yfnuaa/stm8_train_air/work_list.txt

1, test timer1 acuracy, use shiboqi
2, teset timer4 acuracy, use shiboqi
3, ??ADC???
4, ?? SHARP??
5, ?? CO2?????
