yfnuaa/stm8_train_air/Sensor_power_pwm_stuf/Power/NCP1034_EVB_SCHEMATIC.PDF

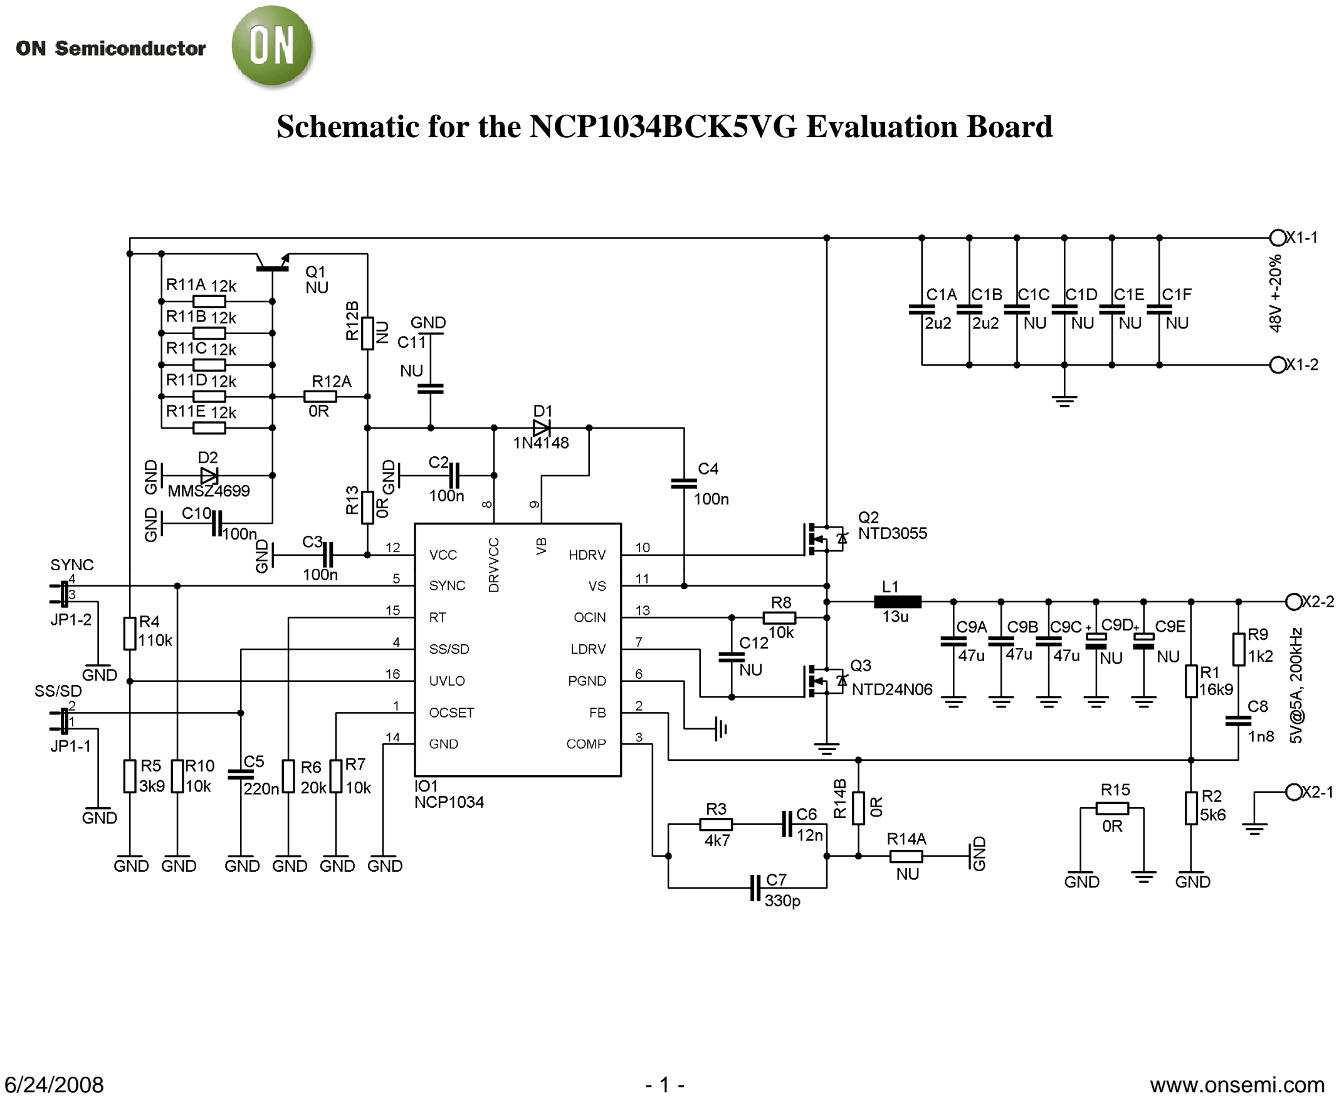
[picture p1: page 1]

6/24/2008 | - 1 - | www.onsemi.com

Schematic for the NCP1034BCK5VG Evaluation Board
