yfnuaa/stm8_train_air/MG812_ADC_ref.png

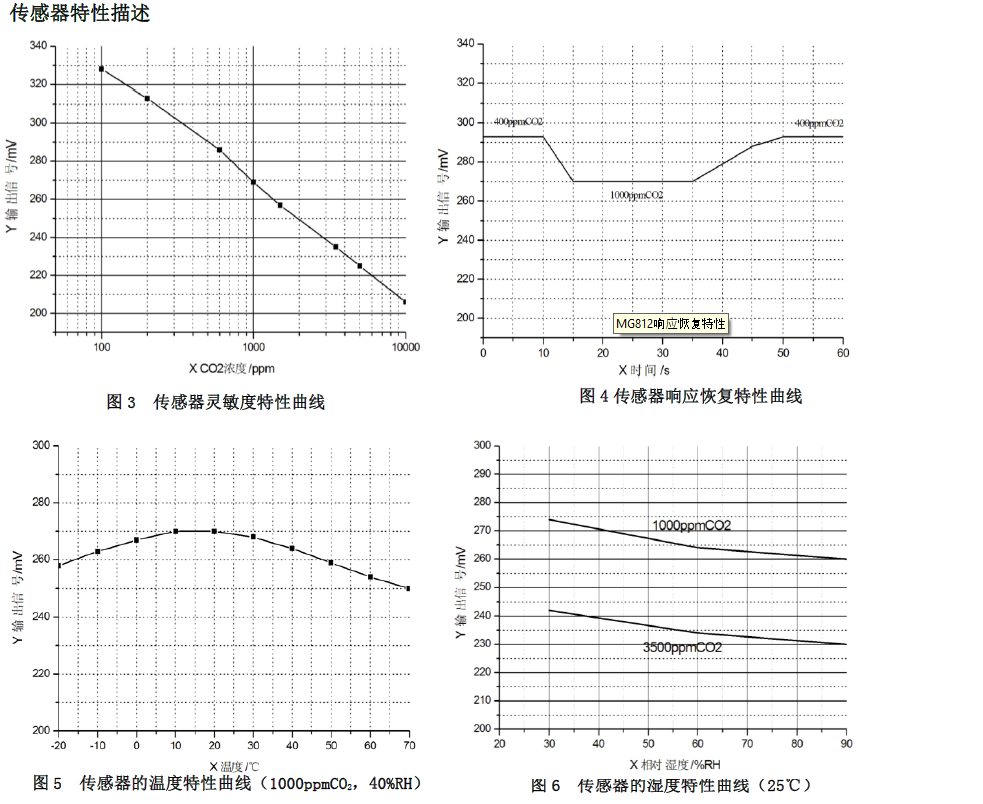
MG812_ADC_ref.png
