yfnuaa/stm8_train_air/sharp_ADC_ref.png

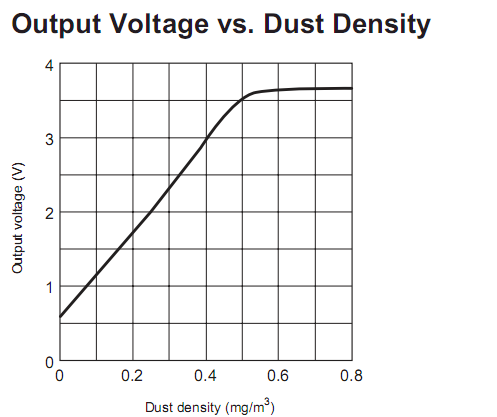
sharp_ADC_ref.png
