yfnuaa/stm8_train_air/trainAir-spec&cost.xlsx

Sheet: cost
MainBoard |  |  |  |  |  | Power Board
fixed | TFT | 17 |  |  |  | fixed |  | H6201 | SL3038
 | PCB | 2.7 |  |  |  |  | PCB | 2.7 | 2.7
 | smt | 5 |  |  |  |  | smt | 5 | 5
 | power | 16.8 |  |  |  |  | 芯片 | 1.5 | 1.5
 | CO2 | 40 |  |  |  |  | 双二极管 | 0.5 | 0.5
 | PM2.5 | 18 |  |  |  |  | MOS | 1.5 | 1.5
 | 插针+座 | 0.8 | 4*0.2 |  |  |  | 电感 | 0.6 | 0.6
 | MCU | 1
 | touch芯片 | 0.9 |  |  |  | variable | 电容+电阻 | 5 | 5
 | OP | 1.3
 | 线束 | 1.6 | 0.8*2
 | 散热器 | 1.2
variable | 电容+电阻 | 5
TOTAL |  | 111.3
 |  |  |  |  |  | TOTAL |  | 16.8 | 16.8
SMT fee
 | main pcb |  |  |  |  |  | power pcb
 |  |  | price | count |  |  |  |  | price | count
 | point | 46 | 0.015 | 1000 | 690 |  | point | 46 | 0.015 | 1000 | 690
 | insert point | 74 | 0.04 | 1000 | 2960 |  | insert point | 74 | 0.04 | 1000 | 2960
 | meta types | 22 | 10 | 1 | 220 |  | meta types | 22 | 10 | 1 | 220
 | engine fee | 0 | 100 | 1 | 100 |  | engine fee |  | 100 | 1 | 100
 | metal net | 0 | 80 | 1 | 80 |  | metal net |  | 80 | 1 | 80
 | total fee |  |  |  | 4050 |  | total fee |  |  |  | 4050
 |  |  |  |  |  | 工程费100元，物料费用是220元，贴片是345元（现在是0.015一个点），插件1480元（0.04一个点），钢网是80元
嘉立创的价格 嘉立创不提供自带料
举例：有5片板子需要SMT贴片，每片板子上200个焊点。那么，5片 x 200个焊点 = 总共1000个焊点，则焊点费：1000 x 0.01 = 10元
SMT总计：10焊点费 + 50工程费 + 0激光钢网 = ￥ 60元
 | power pcb
 |  |  | price | count
 | point | 92 | 0.01 | 1000 | 920
 | insert point | 74 | 0.04 | 1000 | 2960
 | meta types | 0 | 0 | 1 | 0
 | engine fee | 0 | 50 | 1 | 0
 | metal net | 0 | 1 | 1 | 0
 | total fee |  |  |  | 3880

Sheet: spec
需求： | BOM
1 | STM8s003
2 | SHARP + 运放 | PM2.5传感器+GP2Y1014AU粉尘传感器
3 | MG812 + 运放 | 炜盛CO2
4 | TFT液晶/HT621B | 4com 14 seg
5 | touch | 4 key touch
6 | DC-DC | 24V->5V
7 | DC-DC | 96V->24V
8 | MOTO | 24V moto 24vpower on all the time?
9 | PWM | 24V moto 0-5v pwm
10

Sheet: Sheet1
 | power | main board | CO2小板 | MG812 | sharp | Toatal
V1 PCB | 15 | 15
V1 SMT | 0 | 0
V2 PCB | 15 | 40
V2 SMT | 0 | 80
V3 PCB | 30 | 30 | 45
V3 SMT | 146 | 114
 |  |  |  | 40*8 | 100
 | 206 | 279 | 45 | 320 | 100 | 950
