yfnuaa/stm8_train_air/pcb_stuff/v3.0/bom_fan-checked.xlsx

客户BOM清单 |  |  |  |  |  |  |  |  |  | 嘉立创元件库
序号 | Comment | Description | Designator | Footprint | LibRef | Pins | Quantity | 元件名称 | 封装规格 | 元件总数量 | 元件编号 | T层位号 | 元件单价 | 小计 | 收费原因
1 | 2.2uF |  | C4,C2, | 1206+ | C+ | 2 | 2 | 2.2uF (225) ±10% 50V | 1206 | 10 | C12656 | C4, C2 | 0.6918 | 8.3016
2 | 104 | 805 | C23,C20,C19, | 603 | C' | 2 | 3 | 100nF (104) ±10% 50V | 603 | 15 | C14663 | C23, C20, C19 | 0.2799 | 4.1985
3 | 0K | 603 | R25,R15, | 603 | R' | 2 | 1 | 0Ω (0R0) ±1% | 603 | 5 | C21189 | R25 | 0.0195 | 0.0975
4 | 100R | 805 | R11,~~R12~~, | 603 | R' | 2 | 2 | 100Ω (1000) ±1% | 603 | 10 | C22775 | R11, R12 | 0.0195 | 0.195
5 | 100R | 603 | R26, | 603 | R' | 2 | 1 | 100Ω (1000) ±1% | 603 | 5 | C22775 | R26 | 0.0195 | 0.0975
6 | 100 | 805 | R13, | 603 | R' | 2 | 1 | 100Ω (1000) ±1% | 603 | 5 | C22775 | R13 | 0.0195 | 0.0975
7 | 150K | 603 | R30, | 603 | R' | 2 | 1 | 150KΩ (1503) ±1% | 603 | 5 | C22807 | R30 | 0.012 | 0.06
8 | 30K | 603 | R32, | 603 | R' | 2 | 1 | 30KΩ (3002) ±1% | 603 | 5 | C22984 | R32 | 0.018 | 0.09
9 | 4.7K | 805 | R29,R19, | 603 | R' | 2 | 2 | 4.7KΩ (4701) ±1% | 603 | 10 | C23162 | R29, R19 | 0.0193 | 0.193
10 | 4.7K | 603 | R28,R6, | 603 | R' | 2 | 2 | 4.7KΩ (4701) ±1% | 603 | 10 | C23162 | R28, R6 | 0.0193 | 0.193
11 | 100K | 805 | R16, | 603 | R' | 2 | 2 | 100KΩ (1003) ±1% | 603 | 10 | C25803 | R16, R15 | 0.0215 | 0.215
12 | 10K | 805 | R33,R27,R24,R18,R41, | 603 | R' | 2 | 5 | 10KΩ (1002) ±1% | 603 | 25 | C25804 | R33, R27, R24, R18, R41 | 0.0178 | 0.445
13 | 10k | 603 | R54,R52,R51,R1,R53, | 603 | R | 2 | 5 | 10KΩ (1002) ±1% | 603 | 25 | C25804 | R54, R52, R51, R1, R53 | 0.0178 | 0.445
14 | 10K | 603 | R8,R7,R2, | 603 | R | 2 | 3 | 10KΩ (1002) ±1% | 603 | 15 | C25804 | R8, R7, R2 | 0.0178 | 0.267
15 | 10K | 603 | R31, | 603 | R' | 2 | 1 | 10KΩ (1002) ±1% | 603 | 5 | C25804 | R31 | 0.0178 | 0.089
16 | 150 | 805 | R10, | 603 | R' | 2 | 1 | 150Ω ±1% 50ppm [SMT4期 1020] | 805 | 5 | C57863 | R10 | 0.0614 | 1.228
17 | 9013 |  | T9,T8,T5,T1, | 9013 | 9013 | 3 | 4 | S9013 J3 | SOT-23 | 20 | C6749 | T9, T8, T5, T1 | 0.136 | 2.72
18 | 200 | 603 | R5,R40, | 603 | R | 2 | 2 | 200Ω (2000) ±1% | 603 | 10 | C8218 | R5, R40 | 0.0198 | 0.198
19 | D |  | D5, | D0805 | D | 2 | 1 | 1N4148WS | SMA,DO-214AC | 5 | C95872 | D5 | 0.0811 | 0.4055
20 | <-以下为不贴装的元件->
21 | STM8S003F3 |  | U2 | STM8S003F3 | STM8S003F3 | 20 | 1
22 | 220uF |  | ~~C8~~ | C+_6.3-7 | C+ | 2 | 1
23 | BEEPER |  | J6 | BEEP-D12 | BEEPER | 4 | 1
24 | CON3*2 |  | J8,J9,J11,J10 | CON3*2 | CON3*2 | 6 | 4
25 | CON4 |  | J1 | CON4_L | CON4 | 4 | 1
26 | CA3140 |  | U7 | LF353 | CA3140 | 8 | 1
27 | LCD |  | U1 | LCD-DIP-26 | LCD-3 | 26 | 1
28 | AO3401 |  | T7,T4,T10 | AO3401 | AO3401 | 3 | 3
29 | 32.728 |  | X1 | XTAL-32768 | XTAL | 3 | 1
30 | 4.7K | 603 | R | 603 | S | 2 | 1
31 | C+ |  | C24 | C+ | C+ | 2 | 1
32 | 10UF |  | C12 | C+_6.3-5.5 | C+ | 2 | 1
33 | TTP224 |  | U5 | TTP224 | TTP224 | 16 | 1
34 | LM358 | Amps | U4 | LM358 | LM358 | 8 | 1
~~35~~ | ~~5pF~~ | ~~603~~ | ~~C6,C5~~ | ~~603~~ | ~~C~~ | ~~2~~ | ~~2~~
36 | 1uF | 603 | C22,C13,C25 | 603 | C | 2 | 3
37 | 0.1uF | 603 | C7,C3 | 603 | C | 2 | 2
38 | 30pF | 603 | C17,C16,C15,C14 | 603 | C | 2 | 4
39 | 1uF | 805 | C11,C9~~,C10~~ | 603 | C' | 2 | 3
40 | 104 | 603 | C21 | 603 | C' | 2 | 1
41 | HT1621B |  | U3 | HT1621B | HT1621B | 48 | 1
42 | 104 | 603 | C18 | 603 | C | 2 | 1
43 | 10nF | 603 | C1 | 603 | C | 2 | 1
220uf |  | 电解电容 |  | power board | 4.7uF/0805 | 50v
10UF |  | 电解电容 |  |  | 10uF/35V/1206
2.2uf |  | ·0603 |  |  | 10uF/160V/1206
1uf | 105 | ·0603 |  |  | 10uF/50V/1206
0.1uf | 104 | ·0603 |  |  | 1uf 105/1210 | 50v
10nf | 103 | ·0603 |  |  | 330uF/250V | 电解电容
 |  |  |  |  | 470uF/63V | 电解电容
 |  |  |  |  | 100uF/16V | 电解电容
