yfnuaa/stm8_train_air/pcb_stuff/v3.0/bom_pow-checked.xlsx

客户BOM清单
序号 | Comment | Description | Designator | Footprint | LibRef | Pins | Quantity | 元件名称 | 封装规格 | 元件编号 | 元件单价 | 小计 | 收费原因
1 | 12K/0805 | 603 | R4, | 805 | R | 2 | 1 | 12KΩ (1202) ±1% | 805 | C17444 | 0.0339 | 0.1695
2 | 3.9K/1%/0805 | 603 | R8,R5, | 805 | R | 2 | 2 | 3.9KΩ (3901) ±1% | 805 | C17614 | 0.0273 | 0.273
3 | 51K/1206 | 603 | R1, | 1206 | R | 2 | 1 | 51KΩ (5102) ±1% | 805 | C17737 | 0.0336 | 0.168
4 | 240K/1%/0805 | 603 | R7,R6, | 805 | R | 2 | 2 | 240KΩ (2403) ±1% | 805 | C25824 | 0.0222 | 0.222
5 | S3M |  | D3, | S3M | D | 2 | 1 | S3M [SMT4期 ] | SMB,DO-214AA | C47524 | 0.2808 | 2.808 | 10个以内不管购买几个都收费2.8080元 | peak1000v
6 | 0R13/1%/1206 | 603 | R9,R3,R2, | 1206 | R | 2 | 3 | 0.13Ω(R130) ±1% [SMT4期 821] | 1206 | C61472 | 0.0741 | 1.2597
7 | SS3200 |  | D4, | S3M | D | 2 | 1 | SS3200 [SMT4期 ] | SMA,DO-214AC | C65001 | 0.3276 | 3.276 | 10个以内不管购买几个都收费3.2760元 | 200V
9 | 200R/1206 | 603 | R10, | 1206 | R | 2 | 1 | 200Ω (2000) ±1% | 603 | C8218 | 0.0198 | 0.099
10 | SS34 |  | D6, | SS34 | DI | 2 | 1 | SS34 | SMA,DO-214AC | C84635 | 0.2406 | 1.203 |  | SS34为贴片肖特基二极管，常用在小电流的（模型）电调上用，用于电路瞬间整流。其中白色段为负极
11 | <-以下为不贴装的元件->
12 | 4.7uF/0805 | 603 | C6 | 805 | C | 2 | 1 | 50V
13 | 10uF/35V/1206 | 603 | C7 | 1206 | C | 2 | 1
14 | 27V/0.5W |  | Z1 | SOD123 | DI | 2 | 1 | BZT52C18
15 | 10uF/160V/1206 | 603 | C4 | 1206 | C | 2 | 1
16 | XL1509-5.0E1 |  | U1 | XL1509 | XL1509-5.0E1 | 8 | 1
17 | 10uF/50V/1206 | 603 | C5 | 1206 | C | 2 | 1
18 | 100uF/16V |  | C1 | C+_6.3-7 | C+ | 2 | 1
19 | SS110 |  | D7 | S3M | D | 2 | 1 |  |  |  |  |  |  | 100V 1A
20 | 105/1210 | 603 | C9,C2 | 1210 | C | 2 | 2
21 | FUSE |  | F1 | PPTC-10MM | FUSE | 2 | 1
22 | SL18N20 | MOS-N | Q1 | IRFR220N | MOS-N | 3 | 1
23 | FAN |  | U4 | FAN-26*26MM | FAN | 2 | 1
24 | 330uF/250V |  | C3 | C-18-8 | C+ | 2 | 1
25 | CON6 |  | J15 | CON6-1.5mm | CON6 | 8 | 1
26 | 68uH/1mm |  | L2 | L-6MM | L | 2 | 1
27 | CON3 |  | J18,J17,J16 | CON3 | CON3 | 3 | 3
28 | CON3*2 |  | J11,J10,J9,J8 | CON3*2 | CON3*2 | 6 | 4
29 | BZ1303A |  | U*1 | BZ1303A | BZ1303A | 8 | 1
30 | 470uF/63V |  | C8 | C-12-5 | C+ | 2 | 1
31 | 47uH/2A |  | L1 | L-CD75 | L | 2 | 1
32 | CON2 |  | J1 | CON2-5.08 | CON2 | 2 | 1
S3M
SS3200
SS34
BZT52C18 | 27V/0.5W
SS110
4.7uF/0805 | 50V
10uF/35V/1206
10uF/160V/1206
10uF/50V/1206
105/1210 | 50v
330uF/250V | 电解电容
470uF/63V | 电解电容
100uF/16V | 电解电容
