yfnuaa/stm8_train_air/pcb_stuff/v3.0/PowerSystem_bom.xls

Comment | Description | Designator | Footprint | LibRef | Quantity
100uF/16V |  | C1 | C+_6.3-7 | C + | 1.0
105/1210 | 0603 | C2, C9 | 1210 | C | 2.0
330uF/250V |  | C3 | C-18-8 | C + | 1.0
10uF/160V/1206 | 0603 | C4 | 1206 | C | 1.0
10uF/50V/1206 | 0603 | C5 | 1206 | C | 1.0
4.7uF/0805 | 0603 | C6 | 0805 | C | 1.0
10uF/35V/1206 | 0603 | C7 | 1206 | C | 1.0
470uF/63V |  | C8 | C-12-5 | C + | 1.0
SS520 |  | D1, D2 | DO-214AA | D | 2.0
S3M |  | D3 | S3M | D | 1.0
SS3200 |  | D4 | S3M | D | 1.0
SS34 |  | D6 | SS34 | DI | 1.0
SS110 |  | D7 | S3M | D | 1.0
FUSE |  | F1 | PPTC-10MM | FUSE | 1.0
CON2 |  | J1 | CON2-5.08 | CON2 | 1.0
CON3*2 |  | J8, J9, J10, J11 | CON3*2 | CON3*2 | 4.0
CON6 |  | J15 | CON6-1.5mm | CON6 | 1.0
CON3 |  | J16, J17, J18 | CON3 | CON3 | 3.0
68uH/2A |  | L1 | L-CD75 | L | 1.0
100uH/1mm |  | L2 | L-6MM | L | 1.0
SL18N20 | MOS-N | Q1 | IRFR220N | MOS-N | 1.0
51K/1206 | 0603 | R1 | 1206 | R | 1.0
0R13/1%/1206 | 0603 | R2, R3, R9 | 1206 | R | 3.0
12K/0805 | 0603 | R4 | 0805 | R | 1.0
3.9K/1%/0805 | 0603 | R5, R8 | 0805 | R | 2.0
240K/1%/0805 | 0603 | R6, R7 | 0805 | R | 2.0
200R/1206 | 0603 | R10 | 1206 | R | 1.0
TP |  | TP7, TP8, TP9 | CON1 | TP | 3.0
XL1509-5.0E1 |  | U1 | XL1509 | XL1509-5.0E1 | 1.0
FAN |  | U4 | FAN-26*26MM | FAN | 1.0
BZ1303A |  | U*1 | BZ1303A | BZ1303A | 1.0
27V/0.5W |  | Z1 | SOD123 | DI | 1.0
