yfnuaa/stm8_train_air/Sensor_power_pwm_stuf/Power/SL3038/SL3038【Bom清单V1.0】30-100V+Vo=24V_3.0A.xls

深圳市森利威尔电子有限公司
SL3038降压恒压24V/3.0A-BOM
型号:SL3038 |  |  | 规格: Vin=DC(30-100)V;Vo=24V;Io=3.0A | 设计: |  |  | 日期: 2017/01/01
NO. | Part Types | Symbol |  | Qty. | Unit | Vendor | Remarks
1 | 贴片电阻 | R1 R2 R3 |  | 3 | Pcs
2 |  | R4 |  | 1 | Pcs
3 |  | R5 |  | 1 | Pcs
4 |  | R7 R8 |  | 1 | Pcs |  | 输出电压设定分压电阻
5 |  | R7A R8A |  | 1 | Pcs
6 |  | R9 |  | 1 | Pcs |  | 假负载电阻
7 | 贴片电容 | C1 |  | 1 | Pcs
8 |  | C2 |  | 1 | Pcs
9 |  | C3 |  | 1 | Pcs
10 | 电解电容 | EC1 |  | 1 | Pcs
11 |  | EC2 |  | 1 | Pcs
12 | 贴片二极管 | D1 D2 |  | 0 | Pcs |  | 输入防反接二极管
13 |  | D3 D4 |  | 2 | Pcs
14 |  | D5 | 1N4148/100V/0.15A/LL34 | 1 | Pcs
16 | MOS管 | Q1 |  | 1 | Pcs
17 | 电感 | L1 |  | 1 | Pcs
18 | 稳压管 | Z1 | 18V/SOD123/0.25W | 1 | Pcs
19 | IC | U1 |  | 1 | Pcs
20 | PCB板 |  |  | 1 | Pcs | SL3038
备注：
