yfnuaa/stm8_train_air/pcb_stuff/v3.0/FanSystem_bom.xls

Comment | Description | Designator | Footprint | LibRef | Quantity
TP |  | 5V, G1, G2, G3 | CON1 | TP | 4.0
10nF | 0603 | C1 | 0603 | C | 1.0
2.2uF |  | C2, C4 | 1206+ | C + | 2.0
0.1uF | 0603 | C3, C7 | 0603 | C | 2.0
5pF | 0603 | C5, C6 | 0603 | C | 2.0
220uF |  | C8 | C+_6.3-7 | C + | 1.0
1uF | 0805, 0805, 0805, 0603, 0603, 0603 | C9, C10, C11, C13, C22, C25 | 0603 | C', C', C', C, C, C | 6.0
10UF |  | C12 | C+_6.3-5.5 | C + | 1.0
30pF | 0603 | C14, C15, C16, C17 | 0603 | C | 4.0
104 | 0603, 0805, 0805, 0603, 0805 | C18, C19, C20, C21, C23 | 0603 | C, C', C', C', C' | 5.0
C + |  | C24 | C+ | C + | 1.0
D |  | D5 | D0805 | D | 1.0
CON4 |  | J1 | CON4_L | CON4 | 1.0
BEEPER |  | J6 | BEEP-D12 | BEEPER | 1.0
CON3*2 |  | J8, J9, J10, J11 | CON3*2 | CON3*2 | 4.0
10k | 0603, 0603, 0603, 0603, 0805, 0805, 0805, 0603, 0805, 0805, 0603, 0603, 0603, 0603 | R1, R2, R7, R8, R18, R24, R27, R31, R33, R41, R51, R52, R53, R54 | 0603 | R, R, R, R, R', R', R', R', R', R', R, R, R, R | 14.0
200 | 0603 | R5, R40 | 0603 | R | 2.0
4.7K | 0603, 0805, 0603, 0805 | R6, R19, R28, R29 | 0603 | R' | 4.0
150 | 0805 | R10 | 0603 | R' | 1.0
100R | 0805, 0805, 0603 | R11, R12, R26 | 0603 | R' | 3.0
100 | 0805 | R13 | 0603 | R' | 1.0
100K | 0805 | R15, R16 | 0603 | R' | 2.0
0K | 0603 | R25 | 0603 | R' | 1.0
150K | 0603 | R30 | 0603 | R' | 1.0
30K | 0603 | R32 | 0603 | R' | 1.0
S |  | S5 | 0603 | S | 1.0
9013 |  | T1, T5, T8, T9 | 9013 | 9013 | 4.0
AO3401 |  | T4, T7, T10 | AO3401 | AO3401 | 3.0
TP |  | TP7, TP9, TP11, TP20, TP21, TP22, TP23, TP24, TP25, TP26, TP27, TP28 | tp | TP | 12.0
LCD |  | U1 | LCD-DIP-26 | LCD-3 | 1.0
STM8S003F3 |  | U2 | STM8S003F3 | STM8S003F3 | 1.0
HT1621B |  | U3 | HT1621B | HT1621B | 1.0
LM358 | Amps | U4 |  | LM358 | 1.0
TTP224 |  | U5 | TTP224 | TTP224 | 1.0
CA3140 |  | U7 | LF353 | CA3140 | 1.0
32.728 |  | X1 | XTAL-32768 | XTAL | 1.0
