yfnuaa/stm8_train_air/(list of files, cad)

Other CAD files:
stvp_proj/stm8sdownload.stp
train_air_proj.stp
stvp_proj/dowmload.stp
