yfnuaa/stm8_train_air/pcb_stuff/v3.0/PowerSystem-V3.0.pdf

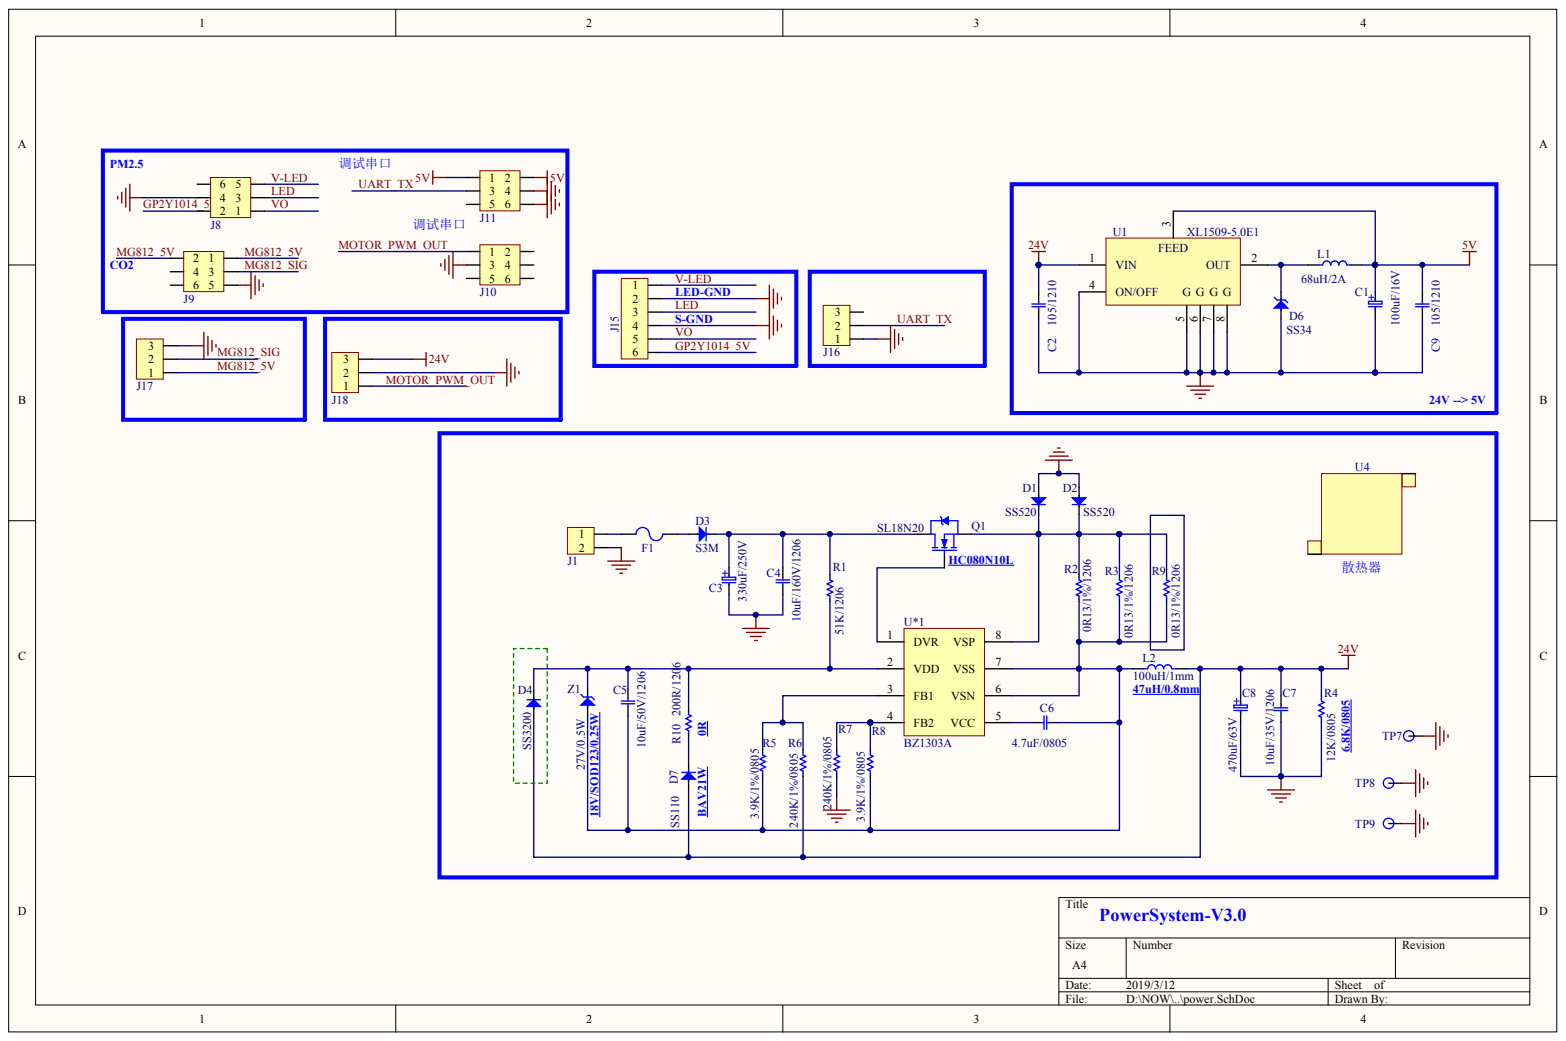
[picture p4: page 1]

FEED

ON/OFF 4 G G | 24V --> 5V

DVR 1 | VSS

VDD 2 | 7

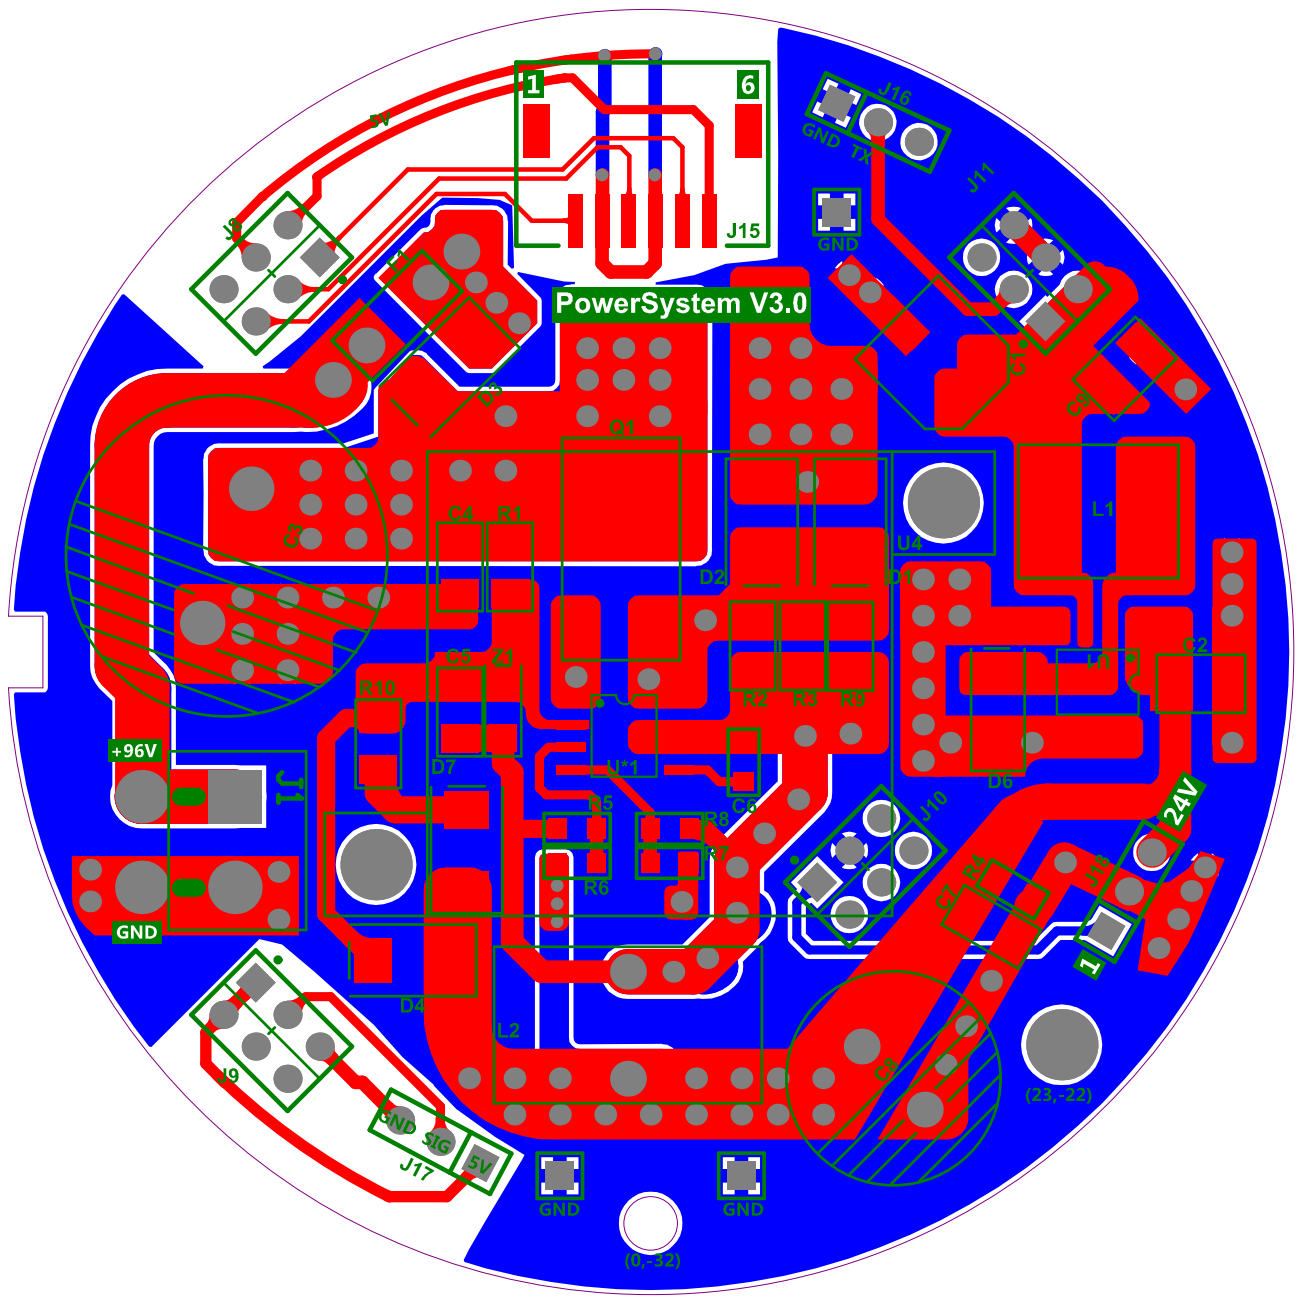
[picture p5: page 2]
