yfnuaa/stm8_train_air/pcb_stuff/v3.0/FanSystem-V3.0.pdf

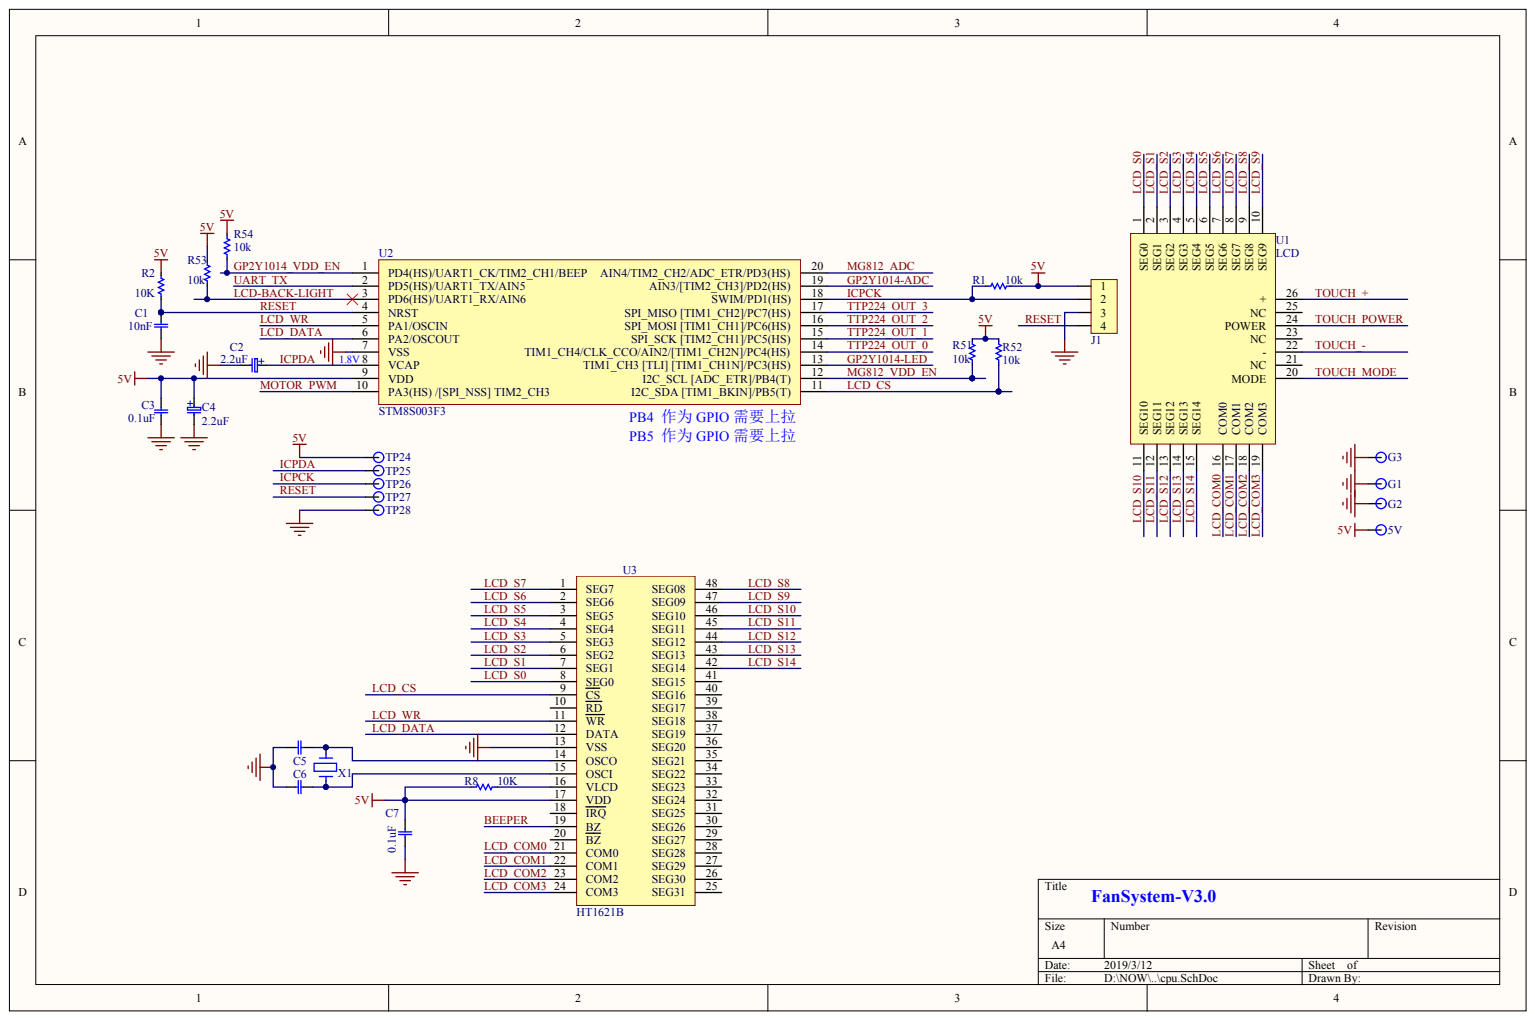
[picture p6: page 1]

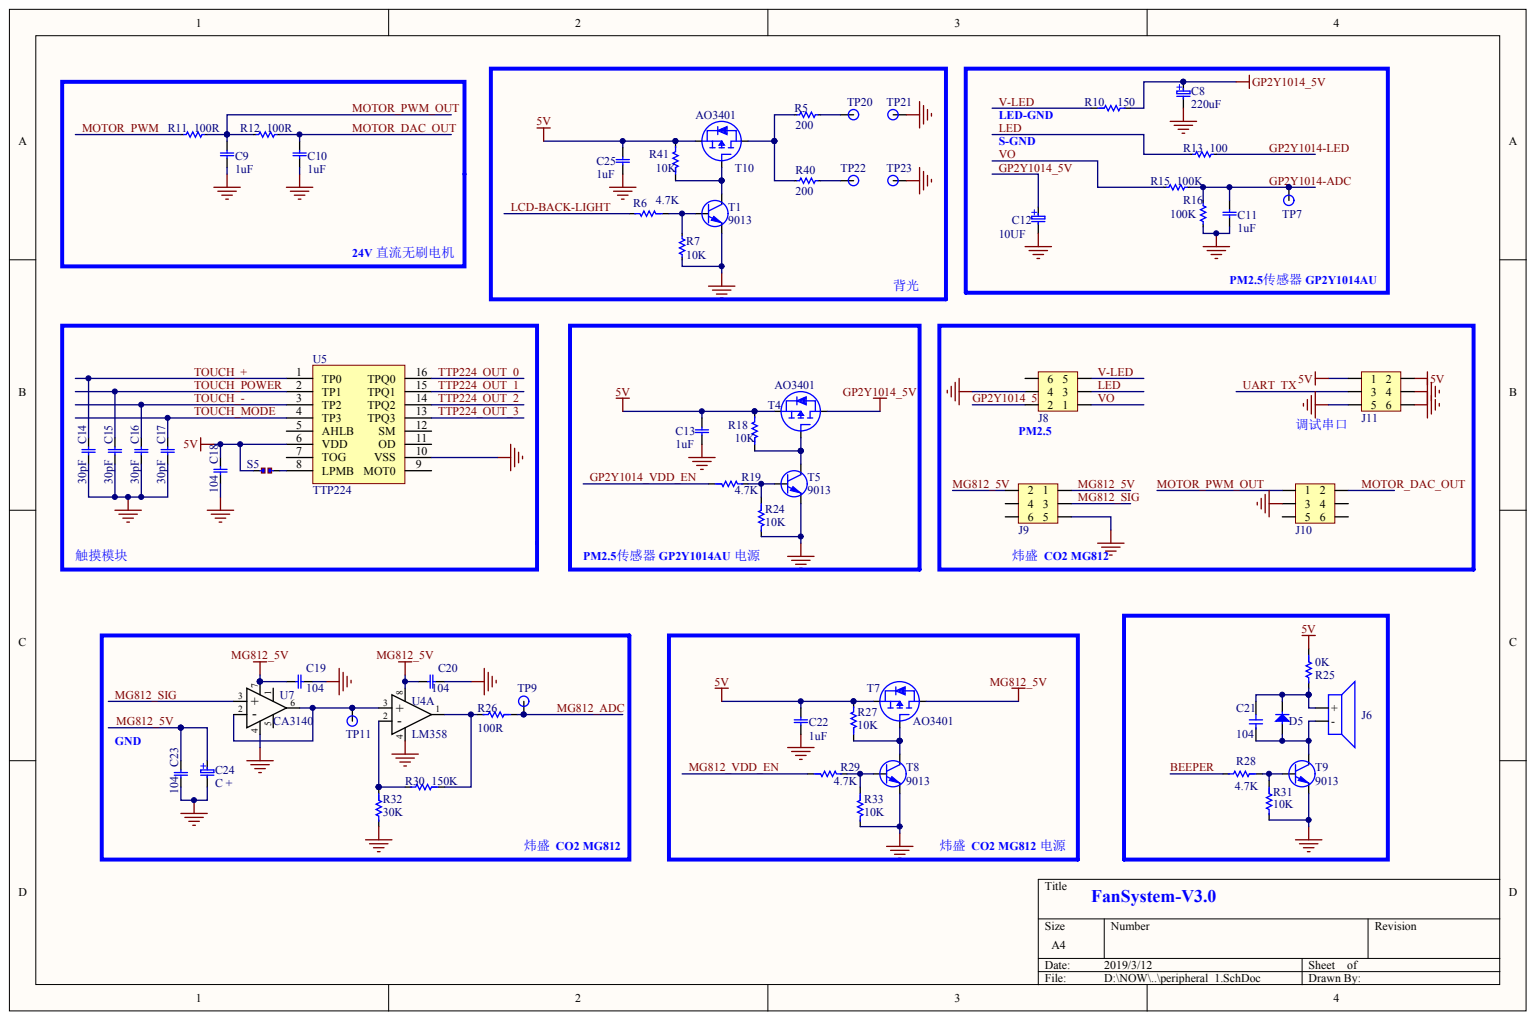
[picture p7: page 2]

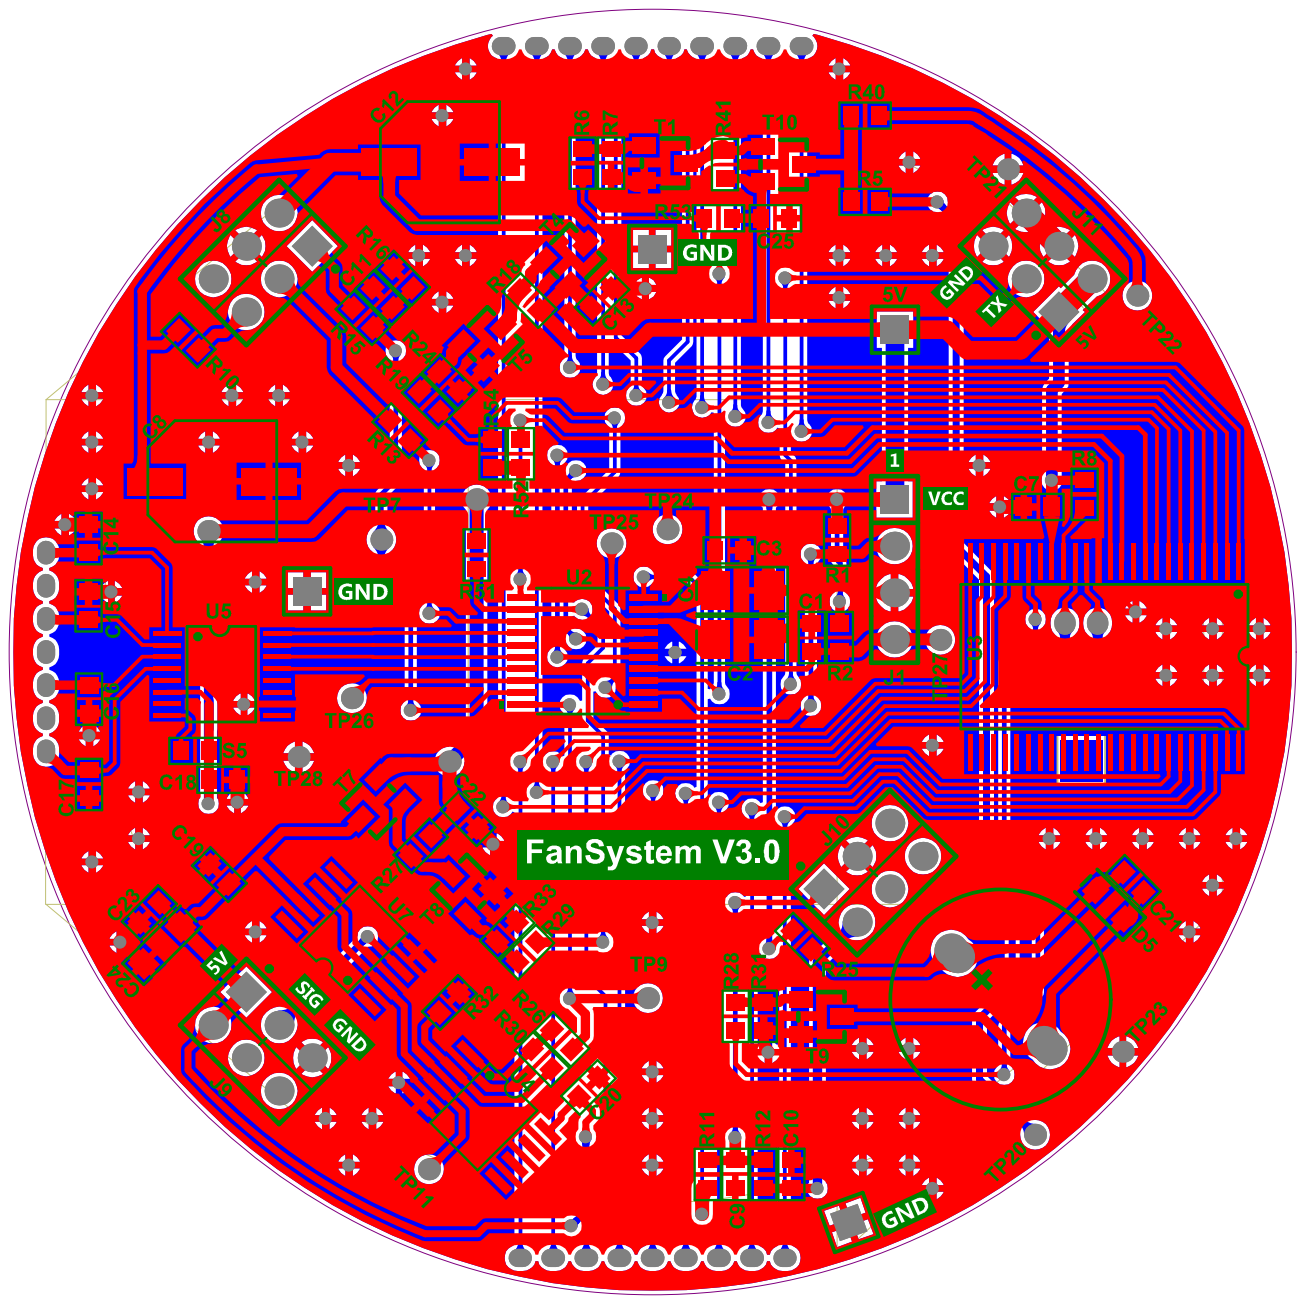
[picture p8: page 3]
