yfnuaa/stm8_train_air/Sensor_power_pwm_stuf/Power/H6201【原理图】VB27+28-85V+TO+24V+2A.pdf

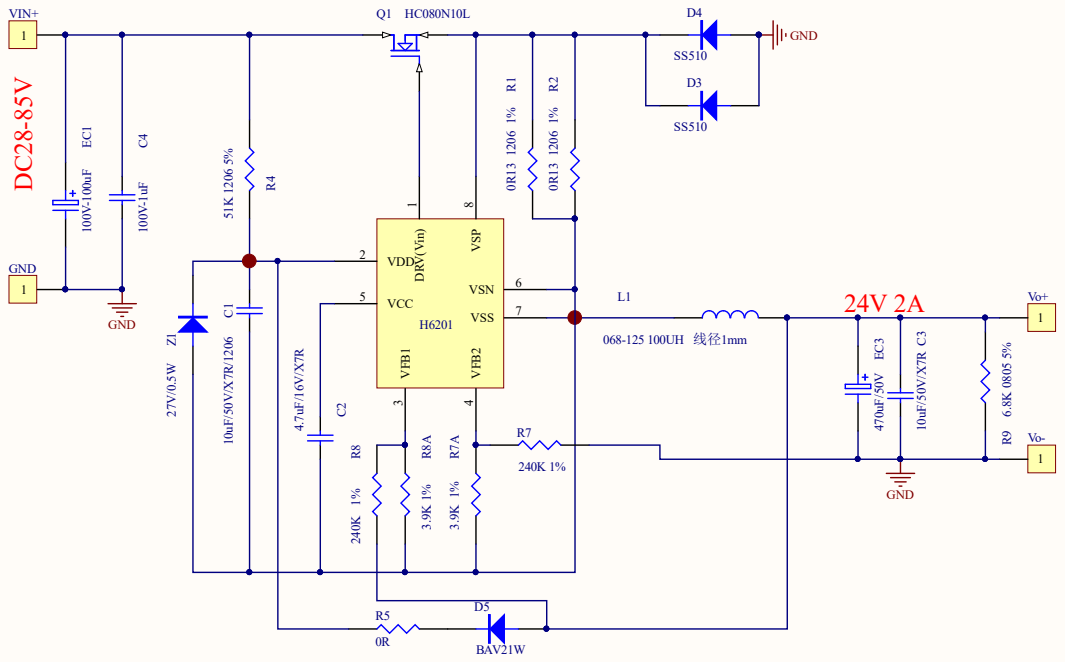
[picture p9: page 1]
