yfnuaa/stm8_train_air/pcb_stuff/v1.0/PowerSystem-V1.0.pdf

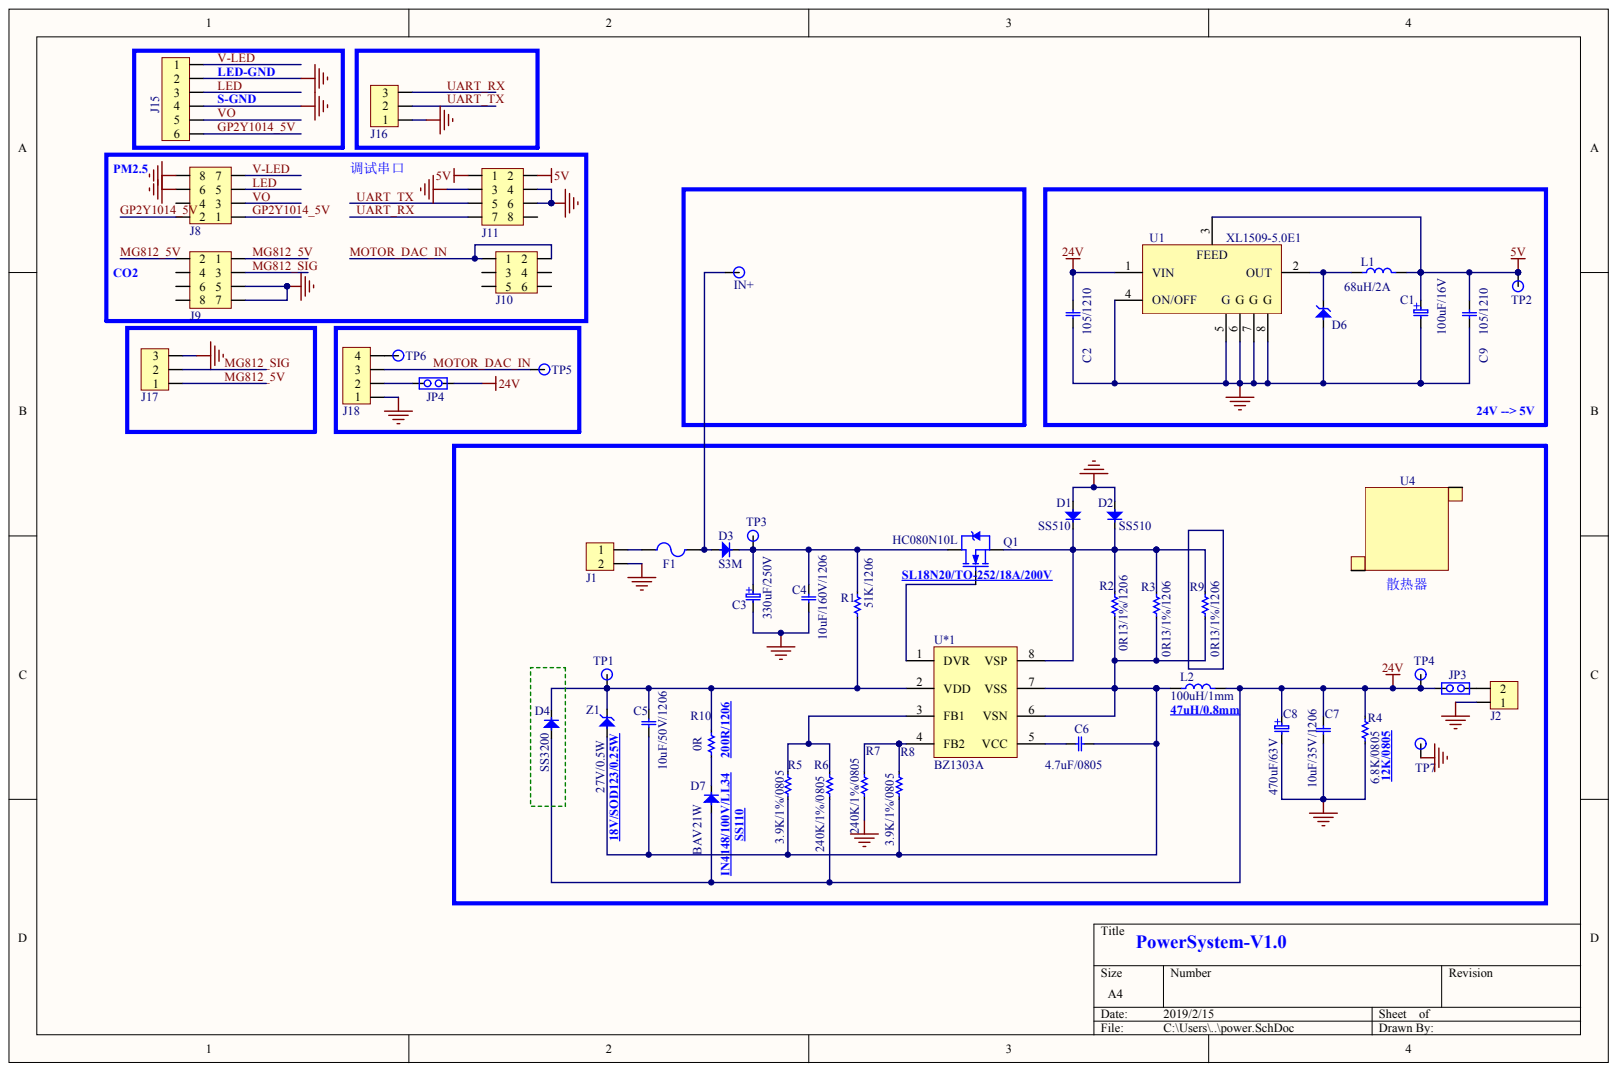
[picture p10: page 1]

FEED

ON/OFF 4 G G | 24V --> 5V

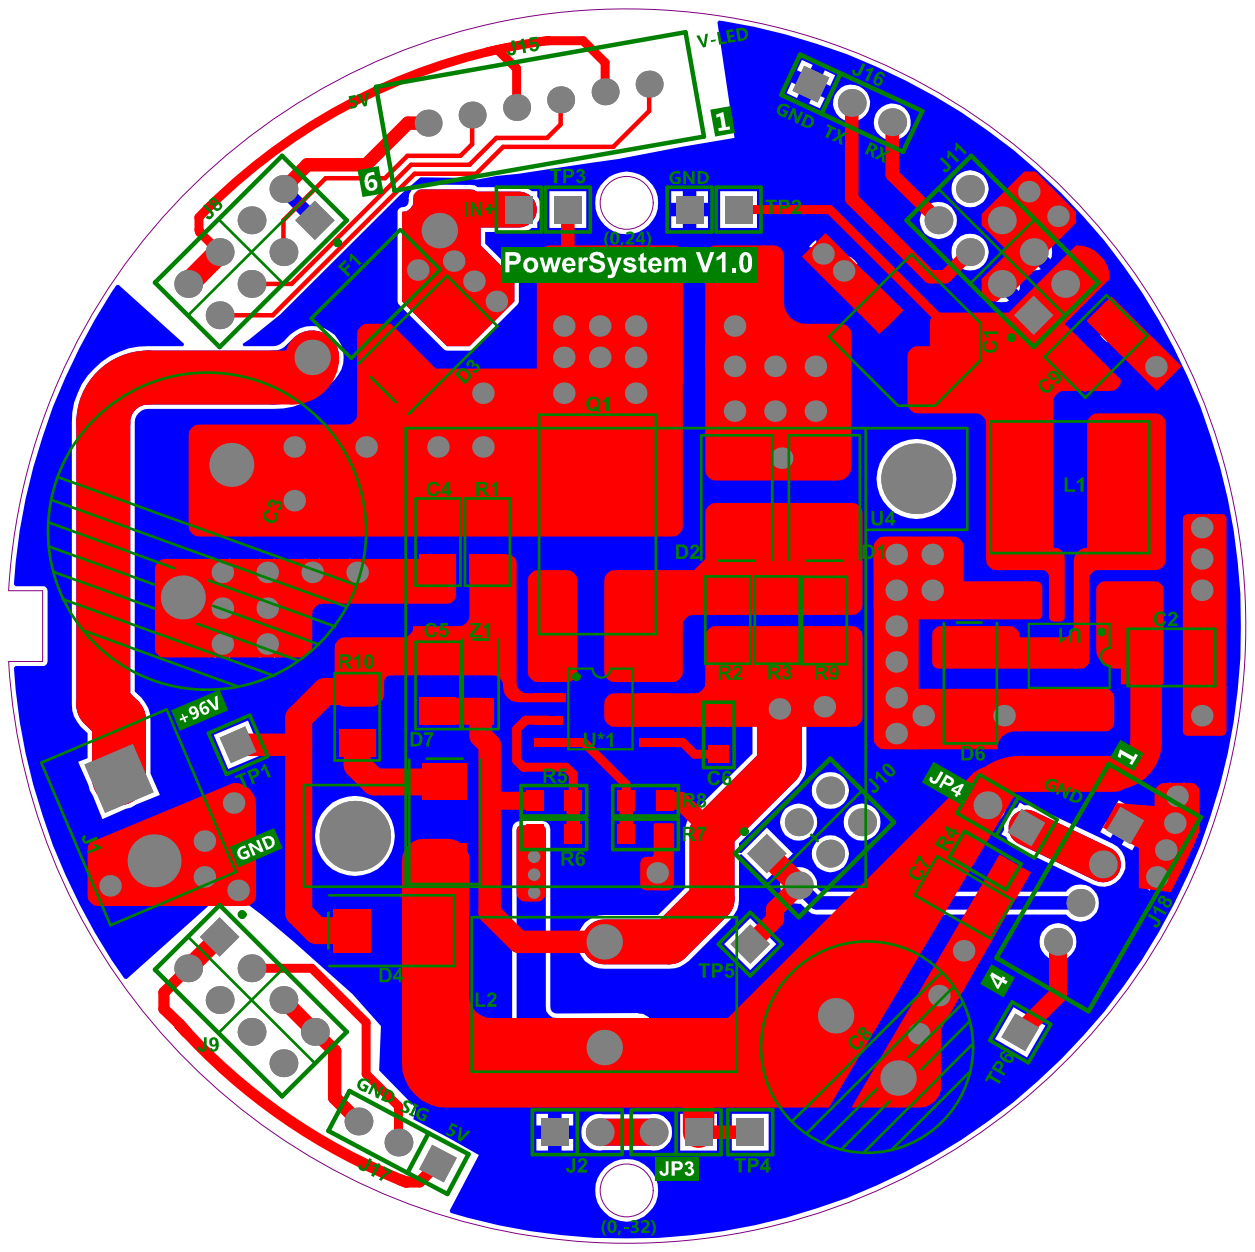
[picture p11: page 2]
