yfnuaa/stm8_train_air/pcb_stuff/v2.0/PowerSystem-V2.0.pdf

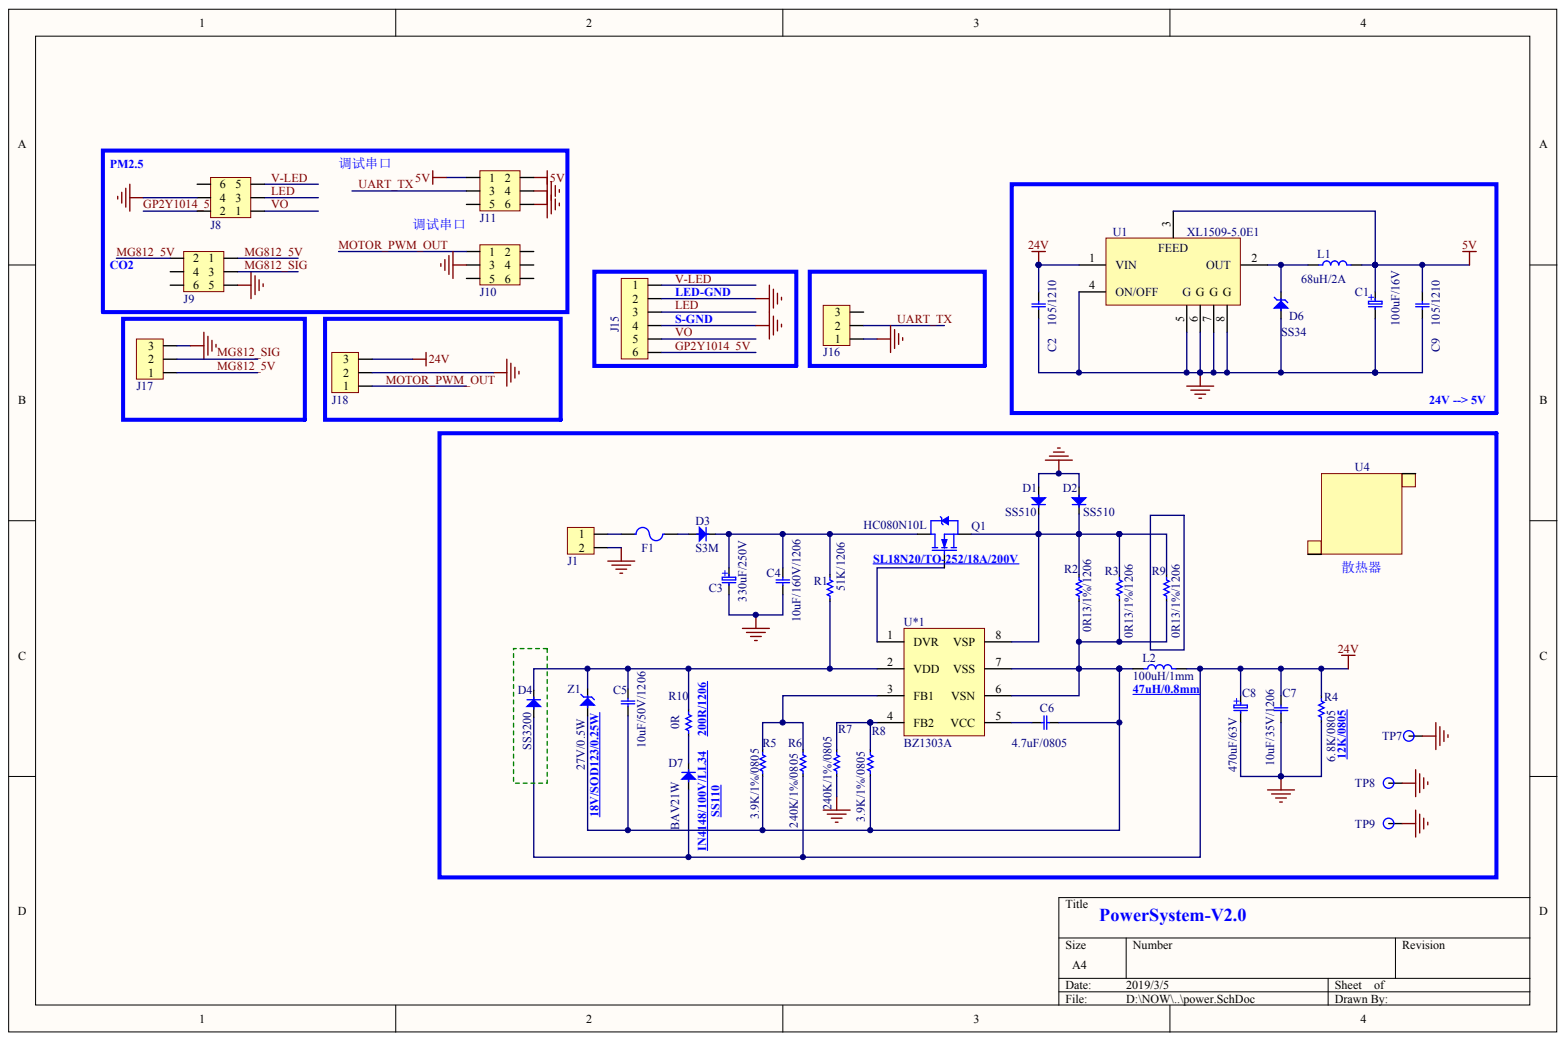
[picture p12: page 1]

FEED

ON/OFF 4 G G | 24V --> 5V

DVR 1 | VSS

VDD 2 | 7

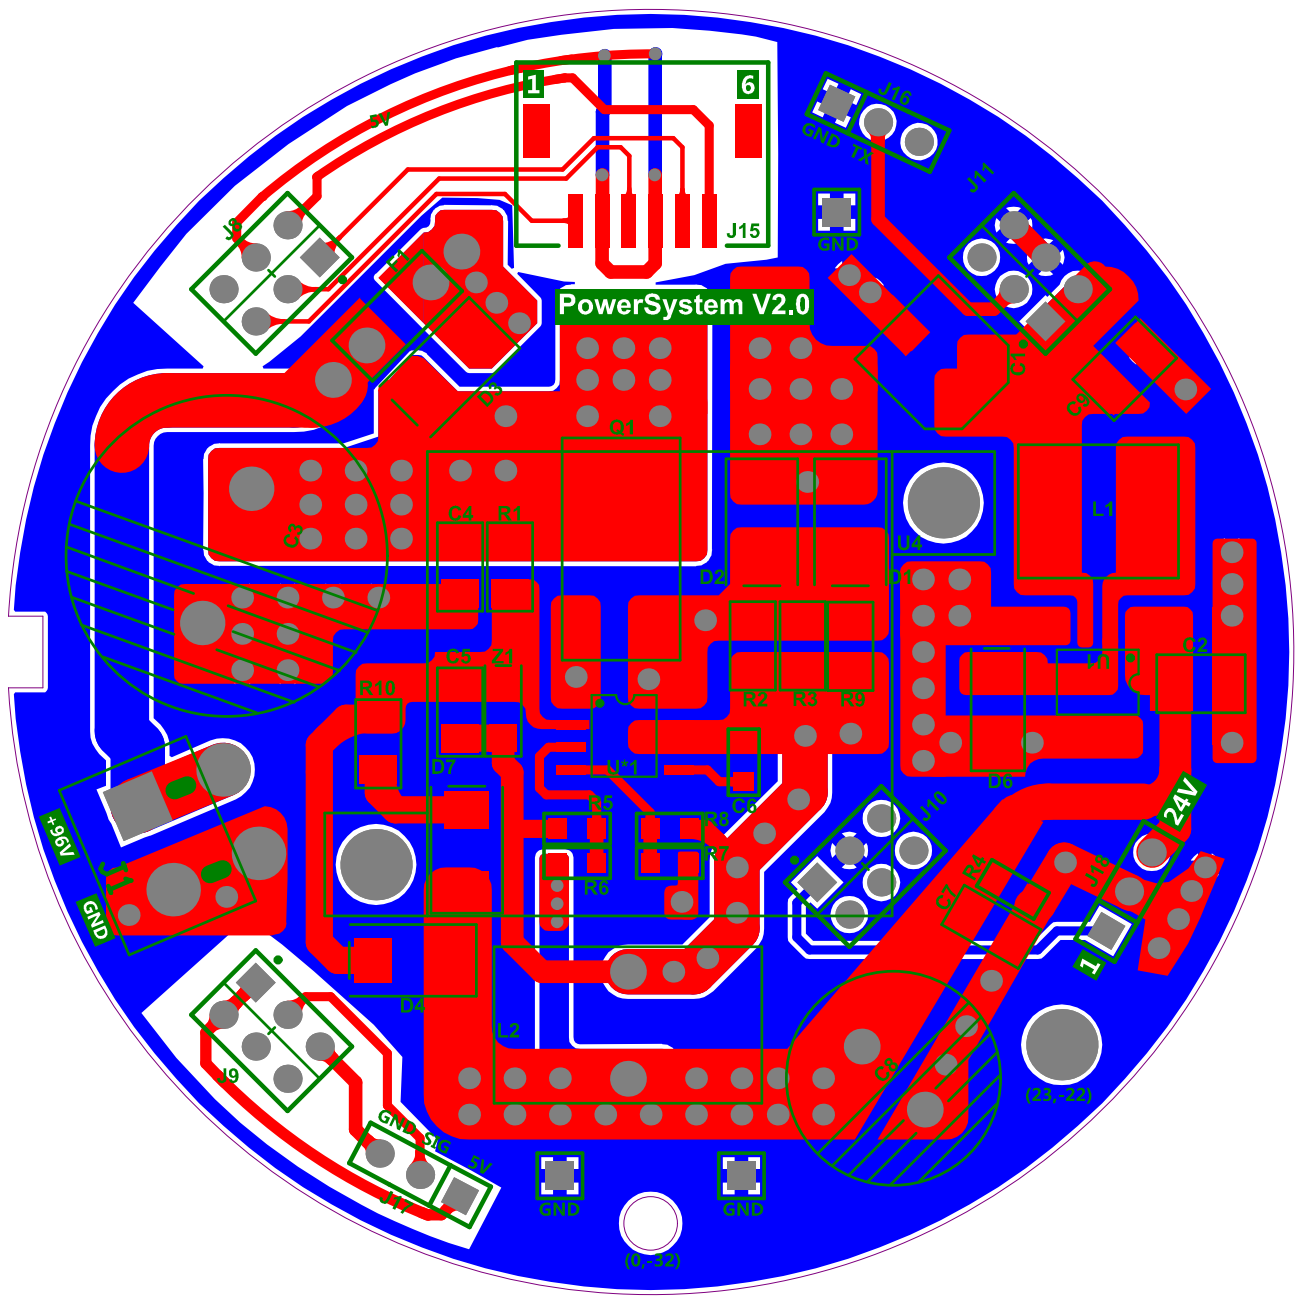
[picture p13: page 2]
