yfnuaa/stm8_train_air/pcb_stuff/v1.0/FanSystem-v1.0.pdf

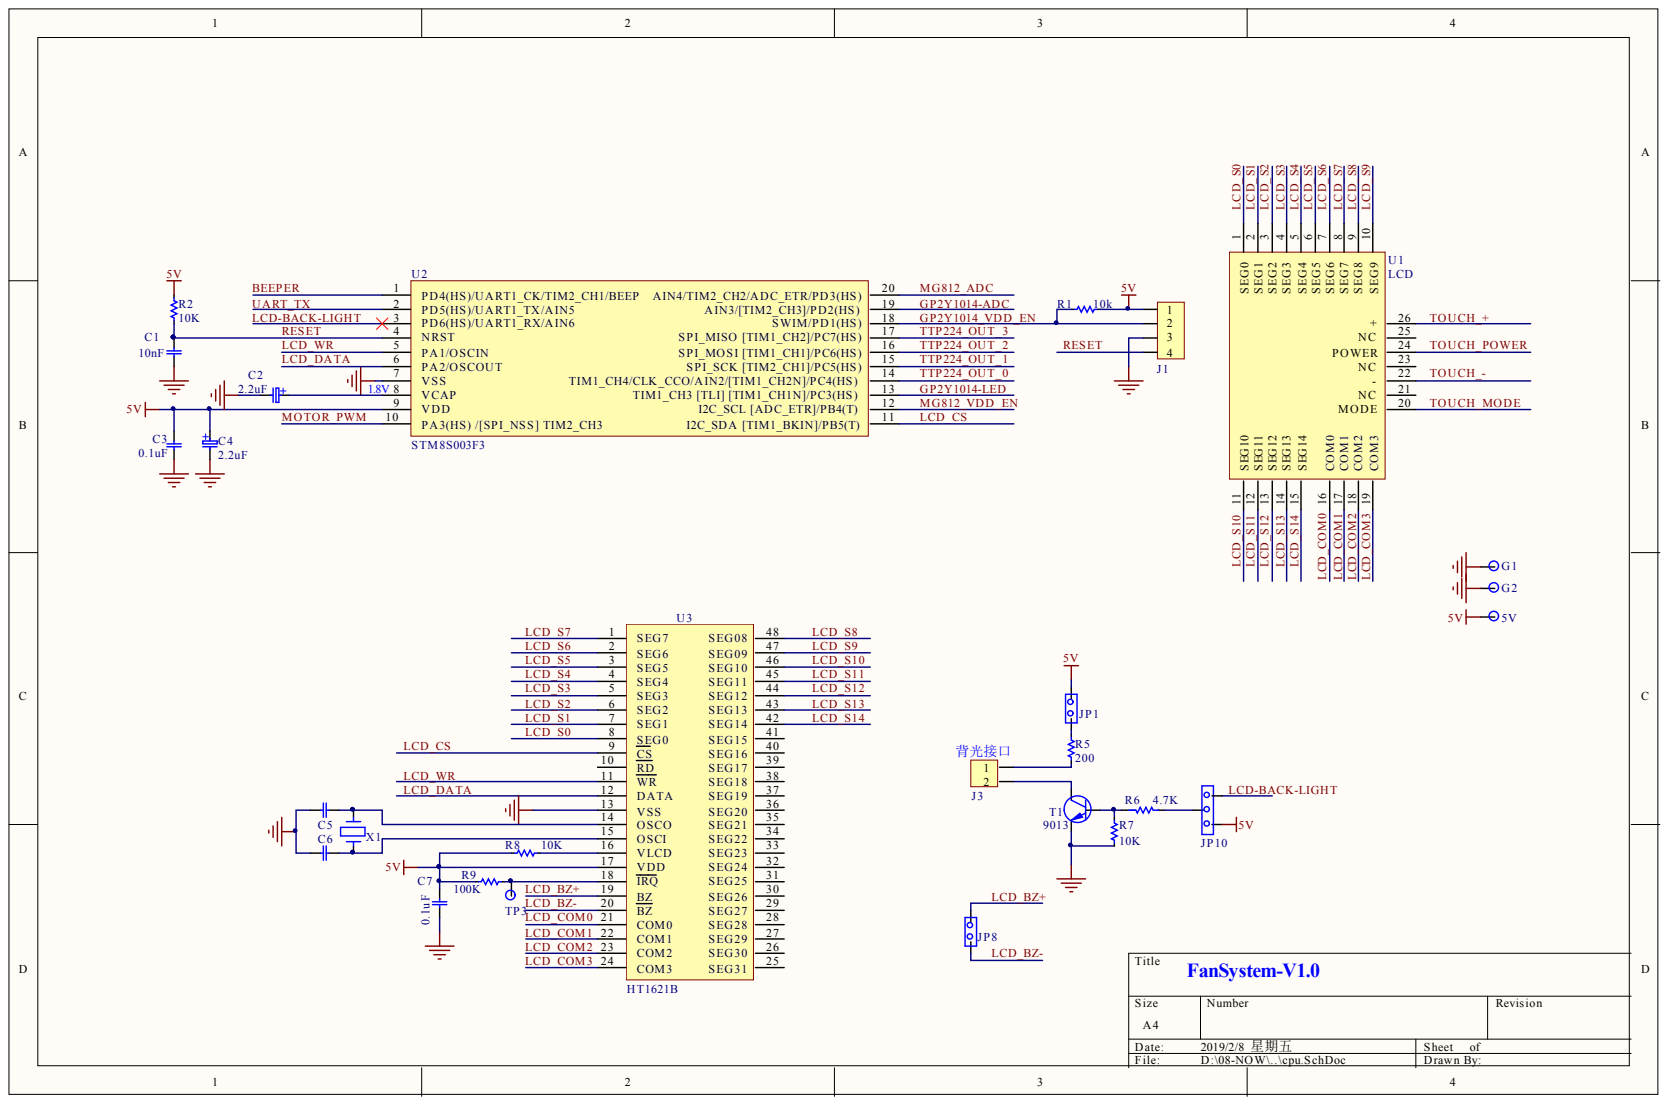
[picture p14: page 1]

X1 C5 | OSCI 15

VLCD 16

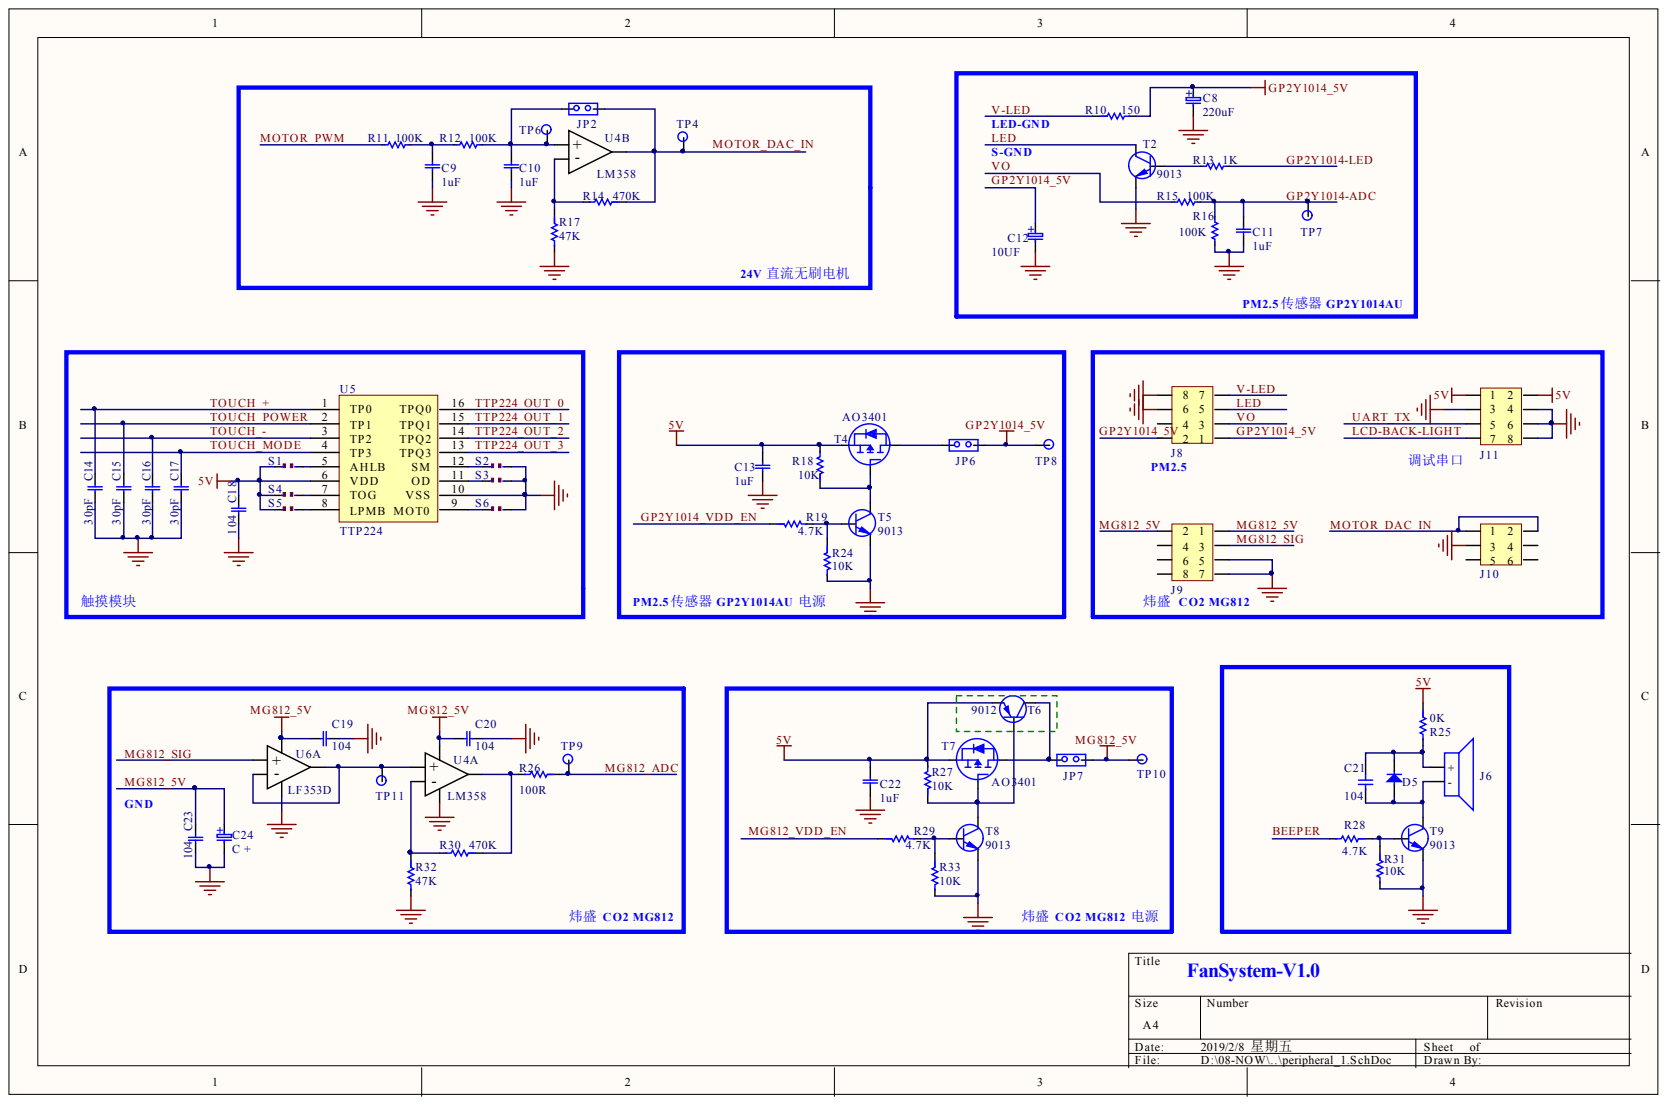
[picture p15: page 2]

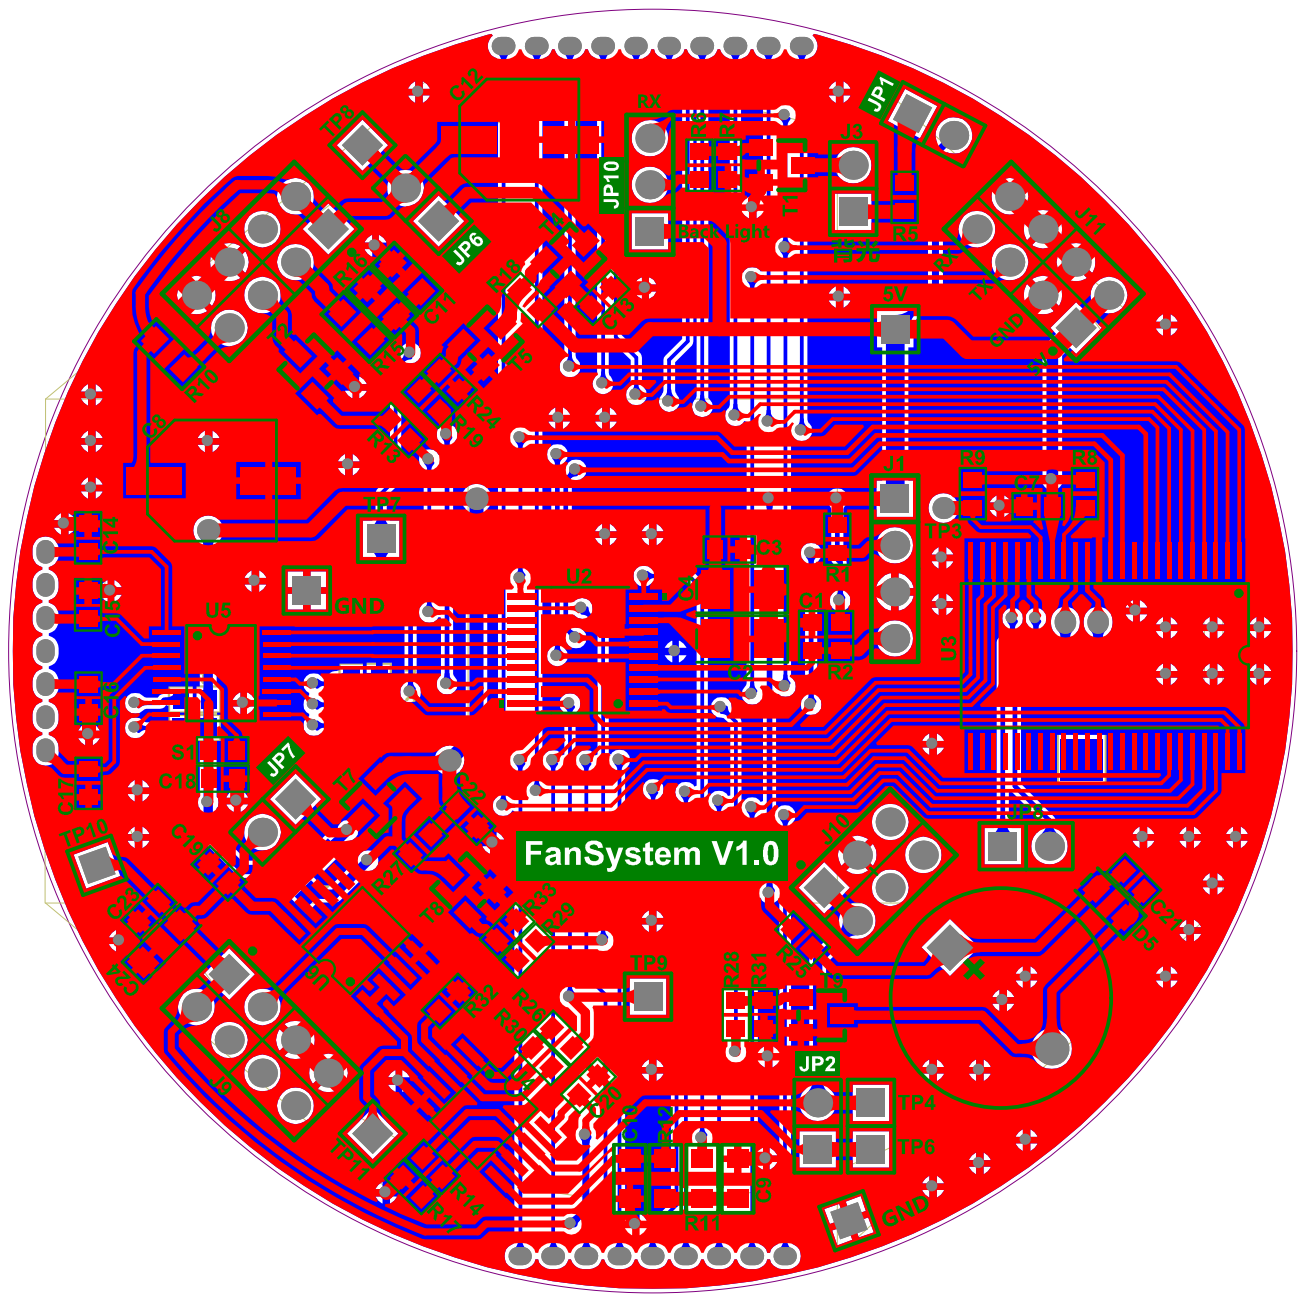
[picture p16: page 3]
