yfnuaa/stm8_train_air/pcb_stuff/v2.0/FanSystem-V2.0.pdf

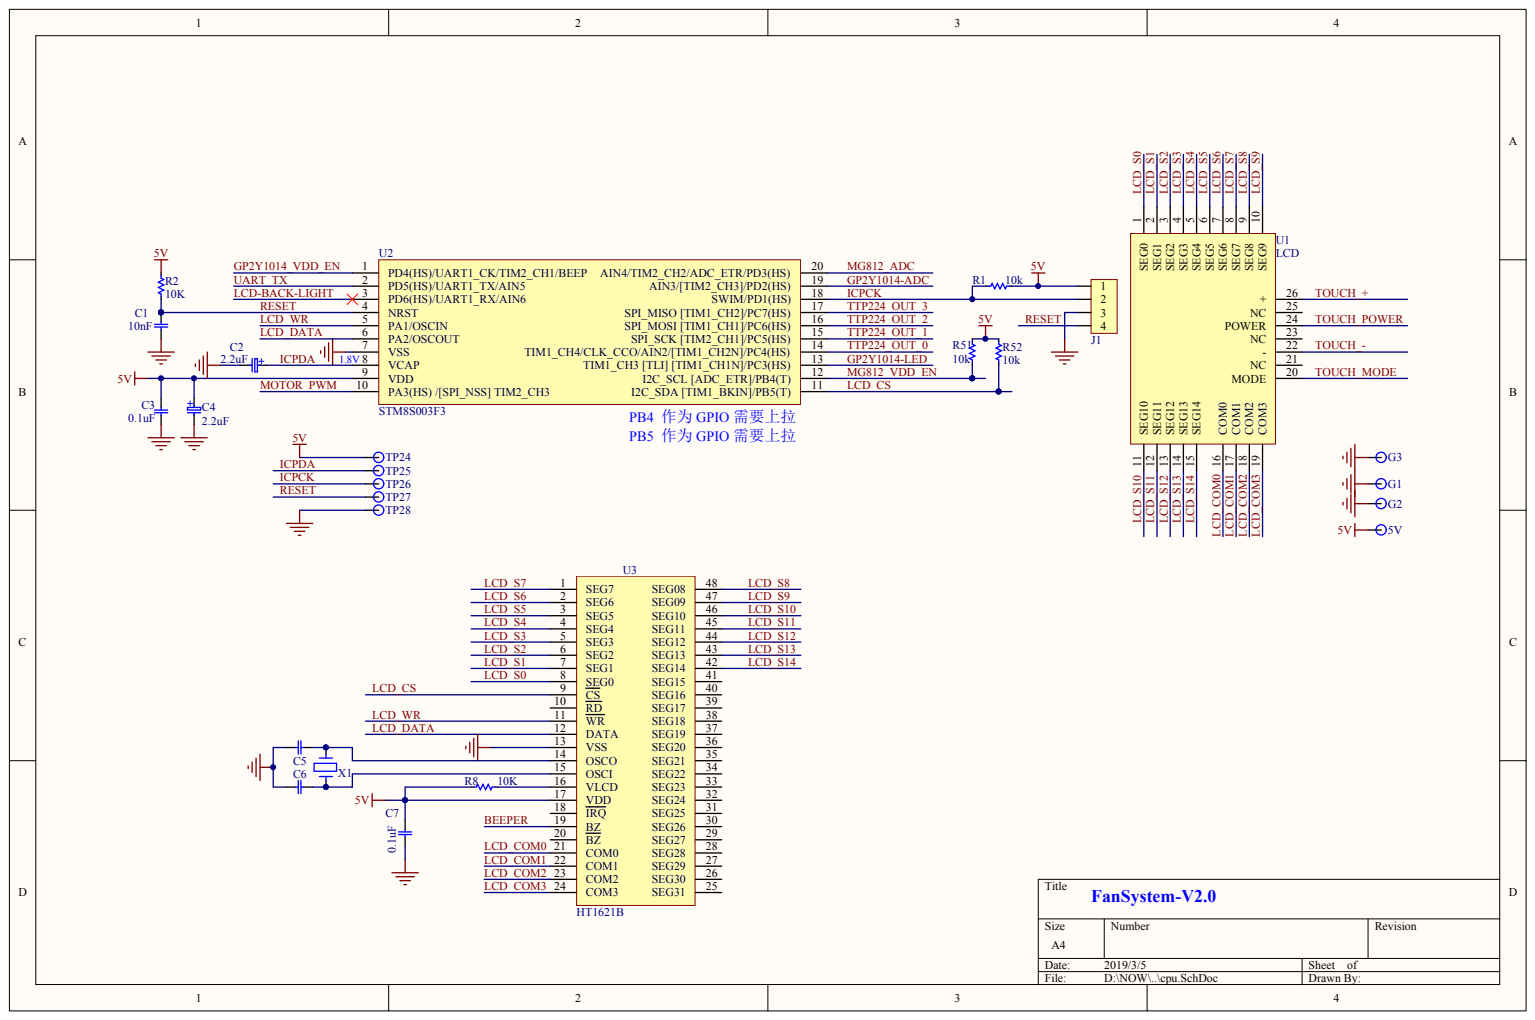
[picture p17: page 1]

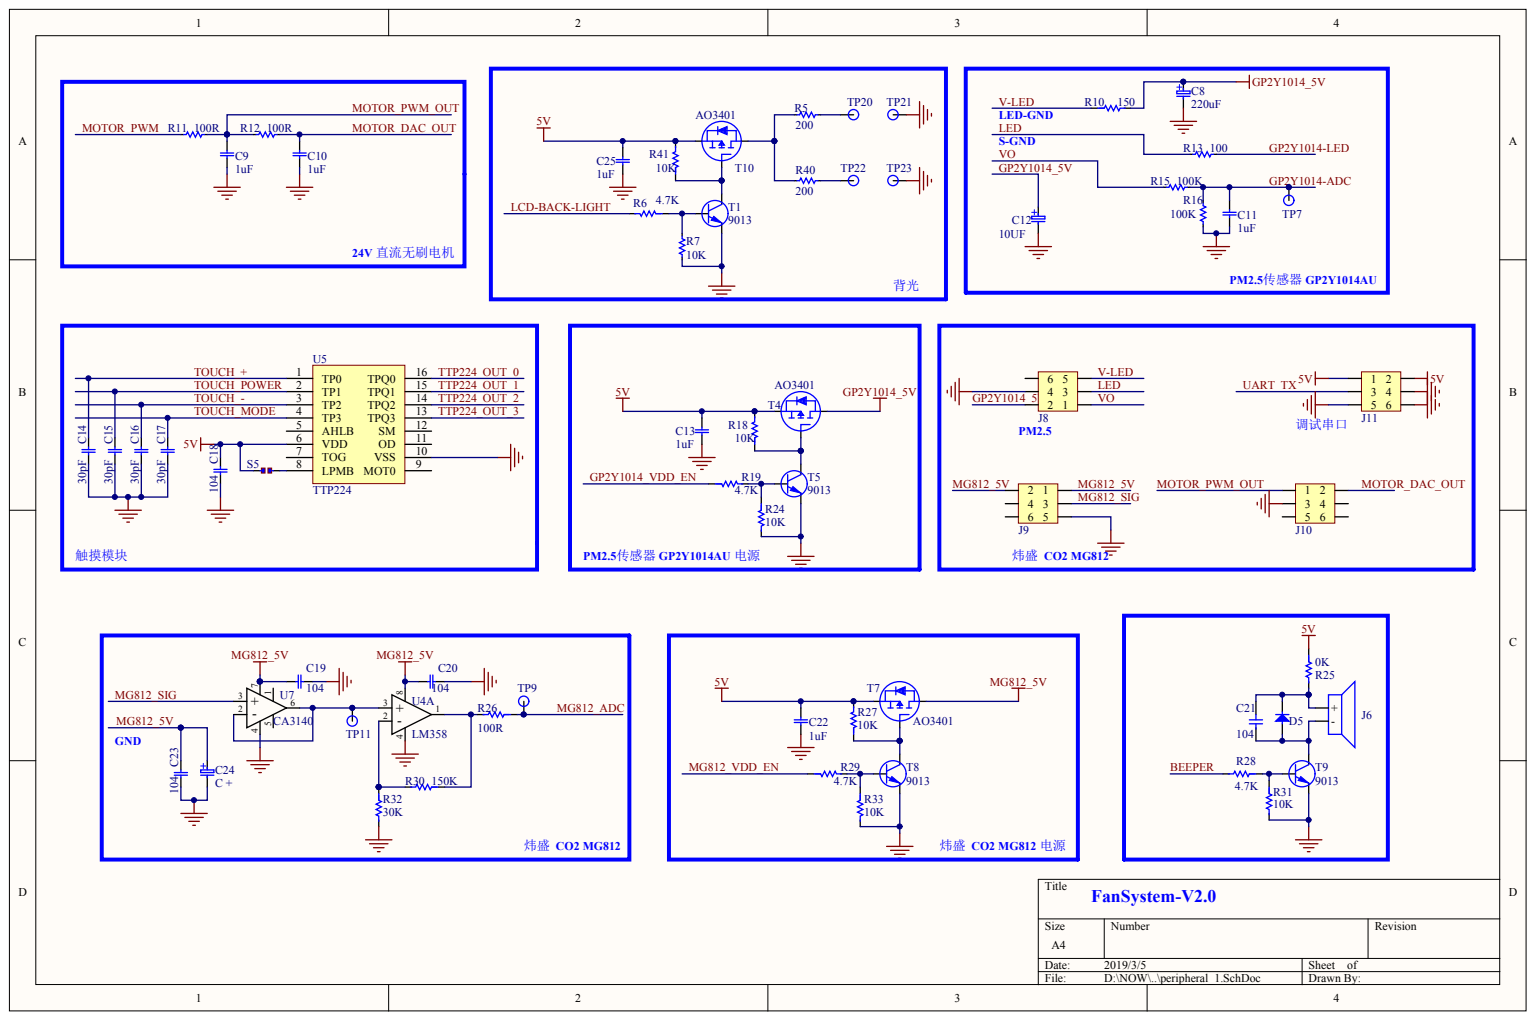
[picture p18: page 2]

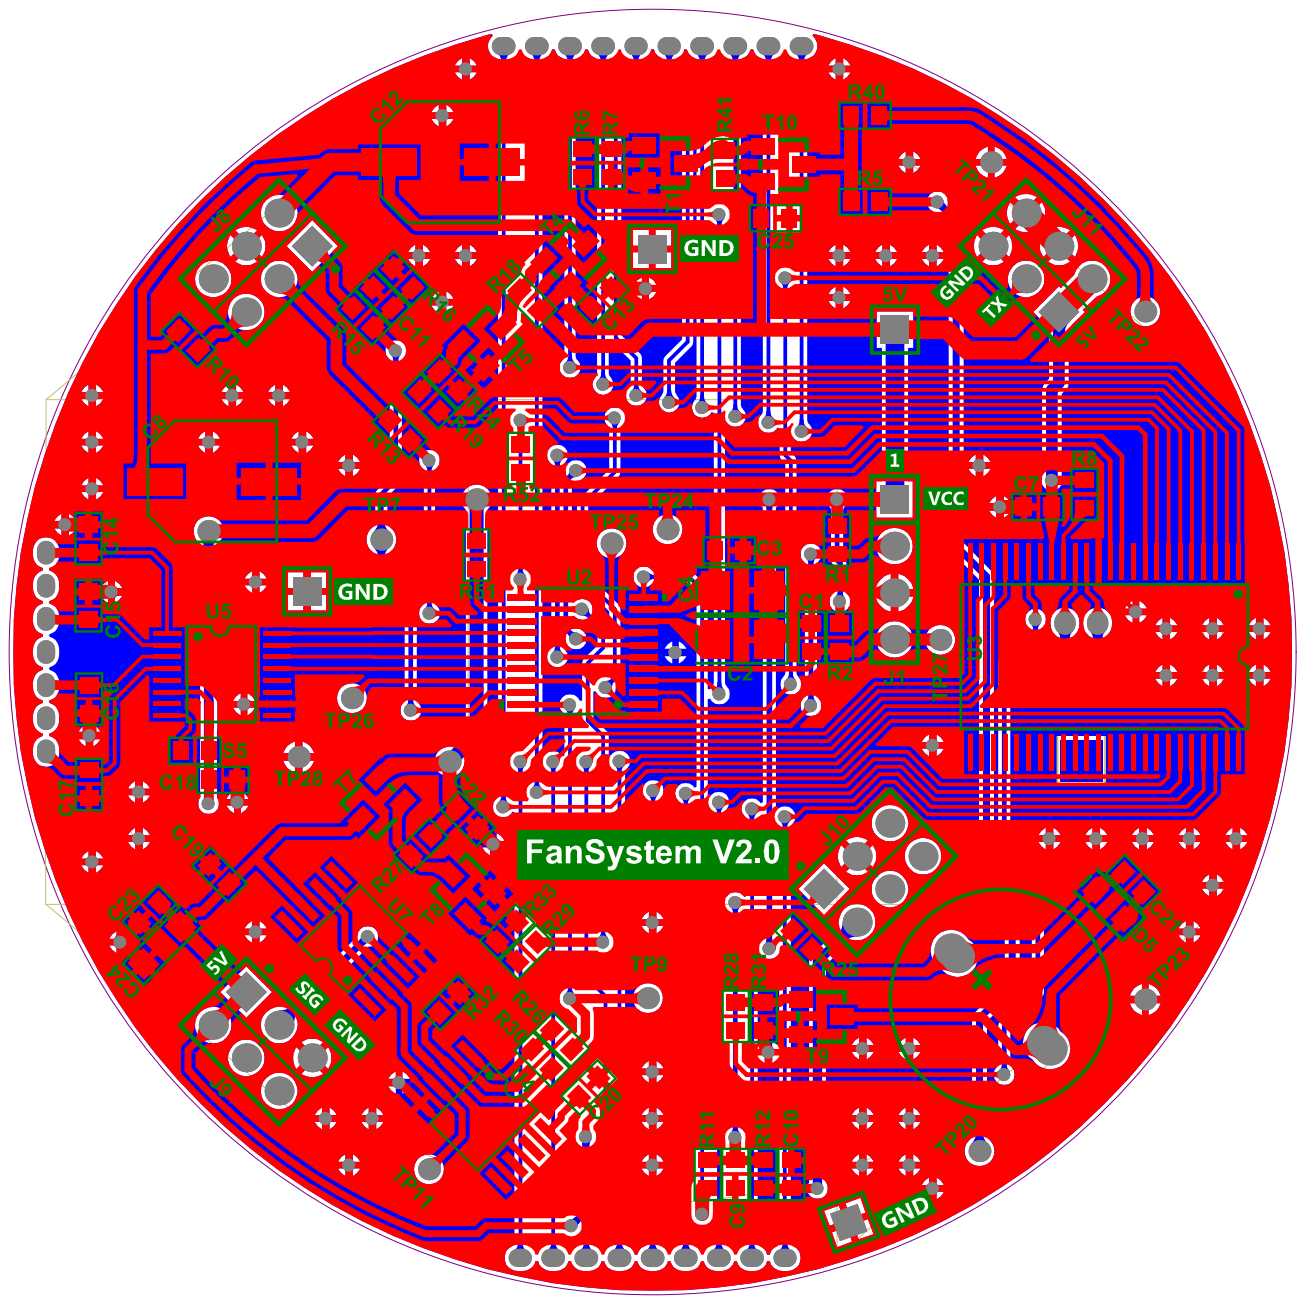
[picture p19: page 3]
