yfnuaa/stm8_train_air/h/flash.h

/**
  ******************************************************************************
  * @file    : flash.h
  * @brief   :
  * @author  : 
  * @version :
  * @date    :
  */ 
#ifndef __FLASH__H__
#define __FLASH__H__

#include "stm8s.h"







#endif
