yfnuaa/stm8_train_air/src/timer4.c

/**
  ******************************************************************************
  * @file    : timer4.c
  * @brief   : used for pm2.5 delay 280us
  * @author  : 
  * @version :
  * @date    :
  */ 

#include "debug.h"
#include "stm8s_tim4.h"
#define TIMER4_C    1
#include "timer4.h"
#include "touch_key.h"
volatile uint8_t g_time4_280us_ok = 0;
volatile uint8_t g_time4_40us_ok = 0;

enum time4_start_mode g_time4_start_mode = e_mode_null;

#if 0
void timer4_isr(void)
{
    if( g_time4_start_mode == e_mode_280_us )
    {
        g_time4_280us_ok = 1;
        g_time4_start_mode = e_mode_null;
        //print("timer4_isr_280");
    }
    else
    {
        g_time4_40us_ok = 1;
        g_time4_start_mode = e_mode_null;
        //print("timer4_isr_40");
    }
    //GPIO_WriteReverse(GPIOB, GPIO_PIN_5);
    TIM4_ClearITPendingBit(TIM4_IT_UPDATE);
    TIM4_Cmd(DISABLE);  
}
#

void timer4_start_280us(void)         
{   
    print("timer4_start_280us");
    
    g_time4_start_mode = e_mode_280_us;
    g_time4_280us_ok = 0;

    //TIM4_Cmd(DISABLE);  
    TIM4_DeInit();  
        #ifdef USE_DEFAULT_CLK_2M
    TIM4_TimeBaseInit(TIM4_PRESCALER_4, 140);      //2M     140
        #else
        TIM4_TimeBaseInit(TIM4_PRESCALER_32,140);      //16 M
        #endif
    TIM4_ITConfig(TIM4_IT_UPDATE, ENABLE);    
    //TIM4_ARRPreloadConfig(ENABLE);    
    TIM4_Cmd(ENABLE);  
}


void timer4_start_40us(void)         
{   
    print("timer4_start_40us");
    
    g_time4_start_mode = e_mode_40_us;
    g_time4_40us_ok = 0;

    TIM4_Cmd(DISABLE);  
    TIM4_DeInit();  
      #ifdef USE_DEFAULT_CLK_2M
    TIM4_TimeBaseInit(TIM4_PRESCALER_2, 40);     //2M   
        #else
        TIM4_TimeBaseInit(TIM4_PRESCALER_16,40);   //???4,????16??.
        #endif
    TIM4_ITConfig(TIM4_IT_UPDATE, ENABLE);    
    //TIM4_ARRPreloadConfig(ENABLE);    
    TIM4_Cmd(ENABLE);  
}
#endif
volatile u16 g_10ms_delay_count = 0;    //不知道 这个的作用
void timer4_isr(void)  // 1ms timer
{
    if(g_10ms_delay_count)
    {
        g_10ms_delay_count --;
    }
    else
    {
        touch_key_Init();
        TIM4_Cmd(DISABLE); 
    }
         
    TIM4_ClearITPendingBit(TIM4_IT_UPDATE);
}
void timer4_init()
{
    TIM4_Cmd(DISABLE);  
    TIM4_DeInit();  
      #ifdef USE_DEFAULT_CLK_2M
    TIM4_TimeBaseInit(TIM4_PRESCALER_32,  63);     //16us each timer   16 * 63 = 1ms.   
        #else
        TIM4_TimeBaseInit(TIM4_PRESCALER_128, 0x7D);       //8 us each timer   8 * 125 = 1ms.   
        #endif
    TIM4_ITConfig(TIM4_IT_UPDATE, ENABLE);    
    TIM4_ARRPreloadConfig(ENABLE);  
}
void timer4_start()
{
    if(g_10ms_delay_count) return;
    g_10ms_delay_count = 0;
    TIM4_Cmd(ENABLE);  
}
