yfnuaa/stm8_train_air/h/utility.h

/**
  ******************************************************************************
  * @file    : utility.h
  * @brief   :
  * @author  : 
  * @version :
  * @date    :
  */
  
#ifndef  _UTILITY_H___
#define  _UTILITY_H___

#include "stm8s.h"

void delay_min(uint8_t min);
void delay_s(uint8_t second);
void delay_280us(void);
void delay_40us(void);


#endif
