yfnuaa/stm8_train_air/STM8S_StdPeriph_Driver/src/stm8s_util.c

 //////////////util//////////////////////////////////////////
 #include "system.h"
 void delay_1ms(void)//1ms延时函数
{
    #ifdef USE_DEFAULT_CLK_2M
    int i=625;
    #else
    int i = 625*8;
    #endif
    while(--i);
 }
 void delay_ms(int ms)//ms延时函数
{
  int i;
  while(--ms)
  {
    delay_1ms();
  }
 }
 //////////////////////////////////
