yfnuaa/stm8_train_air/(commit log)

2019-02-22 rename interrupt.c
2019-02-24 pwm is ready
    [train_air_proj.stp]
2019-02-27 PCB“ ”
2019-02-27 “上电”
2019-03-01 add pcb_bom
    [FanSystem_BOM.xls, PowerSystem_BOM.xls]
2019-03-01 move pcb releate to one folder pcb_stuff
    [FanSystem_BOM.xls, PowerSystem_BOM.xls]
2019-03-01 rm txt in pcb_stuff
2019-03-01 adc value opreate
2019-03-03 PCB V2.0
2019-03-04 co2 pm25 all sensor collect
    [DCDC降压恒流恒压H620X电感及外围参数计算器V30.xls, SL3038【Bom清单V1.0】30-100V+Vo=24V_3.0A.xls, SL3038【原理图】+V01.sch]
2019-03-06 v2.0 all ok
    [FanSystem-V2.0_bom.xls, PowerSystem-V2.0_bom.xls]
2019-03-06 v1.0 v2.0
    [FanSystem-V2.0_bom.xls, FanSystem_BOMV1.0.xls, FanSystem_BOMV1.0.xlsx, PowerSystem-V2.0_bom.xls, PowerSystem_BOMV1.0.xls]
2019-04-03 pcb v4.0 update
